mw31ck3rt/h_da_SmartCane_2023/README.md

# h_da_SmartCane_2023

created by Thomas Eistetter and Marian Weickert as their Masterthesis at Hochschule Darmstadt (h_da)
processing period: 16.01.2023 to 30.10.2023
