mw31ck3rt/h_da_SmartCane_2023/V.1/Hardware/Anschluss_Sensoraufnahme_V1.pdf

Anschluss Sensoraufnahme V1

Elektrischer Anschluss

PS/2 Stecker | PS/2 Buchse | Raspberry Pi Zero W
Aderfarbe | Aderfarbe | GPIO
Rot | Schwarz | GND
Grün | Rot | 5V
Gelb | Gelb | SDA (2)
Orange | Grün | SCL (3)
Schwarz | Braun | Rx (15)
Braun | Weiß | Reserve

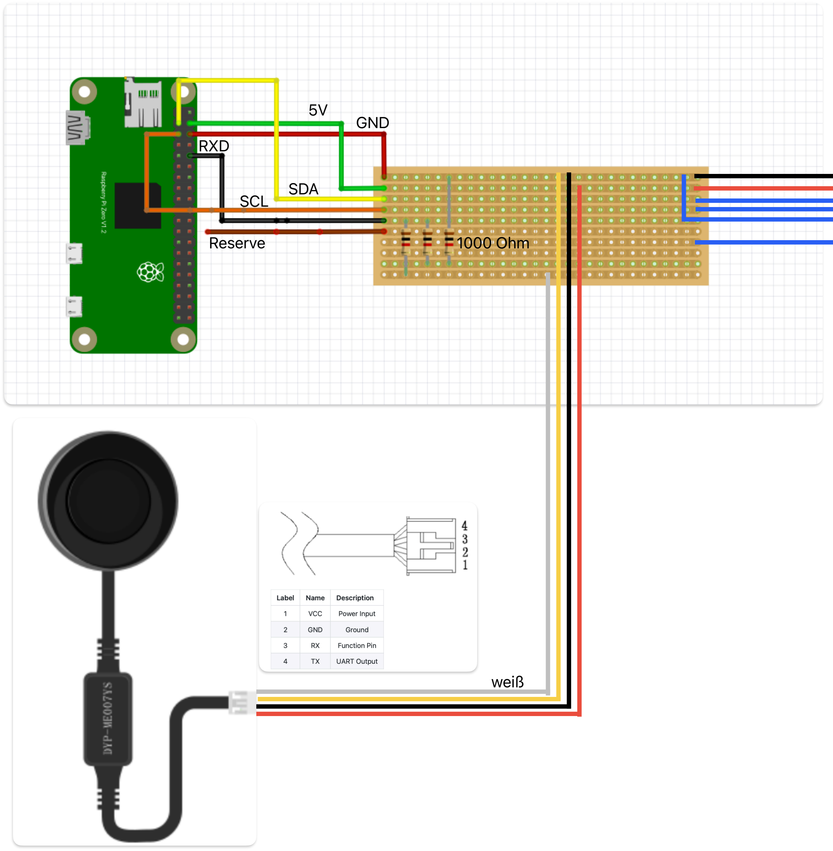
[picture p1: figure]
GND 5V; SDA SCL; RXD; weiß; Reserve; 1000 Ohm

Hinweis: AuNauanleitung für Gehäuse siehe V2

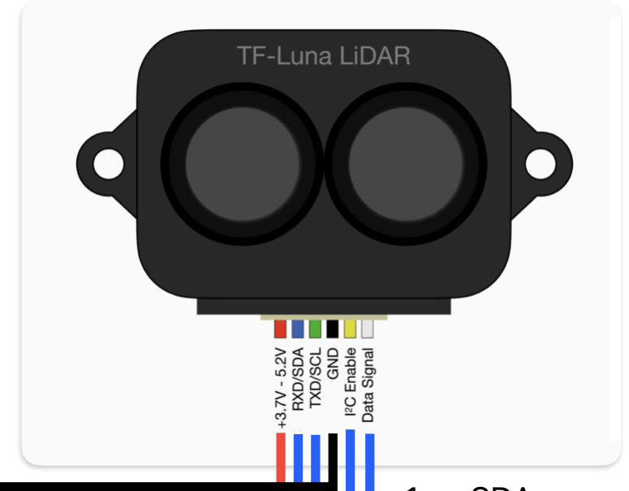
[picture p2: figure]

1 -> SDA
2 -> SCL
3 -> I2C
4 -> Data
