mw31ck3rt/h_da_SmartCane_2023/V.2/Hardware/v2_stueckliste.pdf

### Stückliste V.2

Pos. | Artikel | Typ | Bestellnummer | Menge | ME | Preis / ME | Preis gesamt | Bezugsquelle | Kategorie
1 Blechschraube ISO 1481 | 2,2x6,5 | TOOLCRAFT 228745 Senkschraube (https://www.conrad.de/de/p/toolcraft-228745-senkschrauben-6-5-mm-schlitz-din-7971-c-iso-1481-stahl-verzinkt-20-st-228745.html) | 228745 | 1 | Pack | 1,49 € | 1,49 € | Conrad Elektronik | BLS-Grif
2 Blechschraube ISO 1481 | 2,2x9,5 | TOOLCRAFT 228737 Senkschraube (https://www.conrad.de/de/p/toolcraft-228737-senkschrauben-9-5-mm-schlitz-din-7971-c-iso-1481-stahl-verzinkt-20-st-228737.html) | 228737 | 1 | Pack | 1,99 € | 1,99 € | Conrad Elektronik | BLS-Grif
3 | Blindenlangstock | VISIONU 140cm Blindenlangstock (https://www.amazon.de/gp/product/B019LOFY0Q/ref=ppx_yo_dt_b_asin_title_o08_s00?ie=UTF8&th=1&psc=1) | B019LOFY0Q | 1 | Stk | 27,00 € | 27,00 € | Amazon | BLS-Grif
4 | BLS-Griff inkl. Deckel | 3D-Druck | — | 2 | Stk | 3,00 € | 6,00 € | h_da | BLS-Grif
5 | PS/2 Buchse | BKL Electronic 0204027 (https://www.conrad.de/de/p/bkl-electronic-0204027-miniatur-din-rundsteckverbinder-buchse-einbau-vertikal-polzahl-num-6-schwarz-1-st-734209.html) | 734209 | 2 | Stk | 4,29 € | 8,58 € | Conrad Elektronik | BLS-Grif
6 | Aktuatoren | Grewus EXS241408WB | EXS241408WB | 2 | Stk | | 0,00 € | Grewus GmbH | Bodypack
7 | Aktuatoren | Grewus EXS2608L-03A | EXS2608L-03A | 2 | Stk | | 0,00 € | Grewus GmbH | Bodypack
8 | Drehknopf | Cliff CL170842CR CL170842BR (https://www.conrad.de/de/p/cliff-cl170853br-cl170853br-drehknopf-schwarz-rot-o-x-h-16-8-mm-x-14-5-mm-1-st-704838.html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) | 704838 | 1 | Stk | 0,75 € | 0,75 € | Conrad Elektronik | Bodypack
9 | Drehschalter | TRU COMPONENTS TC-DS4X3L (https://www.conrad.de/de/p/tru-components-tc-ds4x3l-tc-ds4x3l-drehschalter-0-35-a-schaltpositionen-3-3-x-30-1-st-1589500.html) | 1589500 | 1 | Stk | 5,49 € | 5,49 € | Conrad Elektronik | Bodypack
10 | Drucktaster | TRU COMPONENTS TC-10091012 GQ12B-10/J/N/A (https://www.conrad.de/de/p/tru-components-tc-10091012-gq12b-10-j-n-a-drucktaster-48-v-dc-2-a-1-x-aus-ein-tastend-ip65-1-st-2522753.html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) | 2522753 | 2 | Stk | 4,49 € | 8,98 € | Conrad Elektronik | Bodypack
11 | Einplatinencomputer | Raspberry Pi Zero W (https://botland.de/raspberry-pi-zero-module-und-kits/16722-raspberry-pi-zero-wh-basis-kit-5904422344948.html) | RPI-16722 | 1 | Stk | 37,90 € | 37,90 € | Botland | Bodypack
12 Gewinde-Schraube | M2x10 | TOOLCRAFT 815560 Zylinderschrauben M2 10 mm (https://www.conrad.de/de/p/toolcraft-815560-zylinderschrauben-m2-10-mm-schlitz-din-84-stahl-verzinkt-100-st-815560.html) | 815560 | 1 | Pack | 3,49 € | 3,49 € | Conrad Elektronik | Bodypack
13 Gewinde-Schraube | M2x25 | TOOLCRAFT 888677 Zylinderschrauben M2 25 mm (https://www.conrad.de/de/p/toolcraft-888677-zylinderschrauben-m2-25-mm-schlitz-din-84-stahl-verzinkt-1-st-888677.html) | 888677 | 2 | Stk | 0,18 € | 0,36 € | Conrad Elektronik | Bodypack
14 | Gürtelclip | micoshop 5 x 54 x 25 mm Gürtel-Holster-Clip-Verschluss (https://www.amazon.de/gp/product/B07KLJK62B/ref=ppx_yo_dt_b_asin_title_o06_s00?ie=UTF8&psc=1) | B07KY7BCGS | 1 | Pack | 3,99 € | 3,99 € | Amazon | Bodypack
15 | I2C-Multiplexer | Adafruit TCA9548A (https://botland.de/multiplexer/4915-tca9548a-modul-mit-i2c-multiplexer-adafruit-2717-5904422354268.html) | ADA-04915 | 1 | Stk | 9,50 € | 9,50 € | Botland | Bodypack
16 | Kabel BP - BLS | BKL Elektronik 0204097 (https://www.conrad.de/de/p/bkl-electronic-0204097-miniatur-din-rundsteckverbinder-stecker-gerade-polzahl-num-6-violett-1-st-601847.html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) | 601847 | 1 | Stk | 6,99 € | 6,99 € | Conrad Elektronik | Bodypack
17 | Kabel BP - HTS | Lapp Unitronic FD CY 4x0,25mm^2 27427-1 (https://www.conrad.de/de/p/lapp-27427-1-datenleitung-unitronic-fd-cy-4-x-0-25-mm-grau-meterware-609214.html) | 609214 | 1 | m | 5,49 € | 5,49 € | Conrad Elektronik | Bodypack
18 | Kabel Stemma QT | SparkFun PRT-17258 (https://botland.de/qwiic-verbindungskabel/19837-flexibles-qwiic-kabel-mit-4-poligem-stecker-20-cm-sparkfun-prt-17258-5904422352394.html) | SPF-19837 | 2 | Stk | 2,50 € | 5,00 € | Botland | Bodypack
19 | Kabelverschraubung PG7 | TRU COMPONENTS 1593007 (https://www.conrad.de/de/p/tru-components-1593007-kabelverschraubung-pg7-polyamid-silber-grau-ral-7001-1-st-1593007.html) | 1593007 | 3 | Stk | 0,87 € | 2,61 € | Conrad Elektronik | Bodypack
20 | Kippschalter | TRU COMPONENTS TC-9218548 (https://www.conrad.de/de/p/tru-components-tc-9218548-kippschalter-250-v-ac-2-a-2-x-ein-ein-rastend-1-st-2304637.html) | 2304637 | 2 | Stk | 1,29 € | 2,58 € | Conrad Elektronik | Bodypack
21 | Klettband | TOOLCRAFT KL50X1000C (https://www.conrad.de/de/p/toolcraft-kl50x1000c-klettband-zum-aufkleben-haft-und-flauschteil-extrastark-l-x-b-1000-mm-x-50-mm-schwarz-1-m-419956.html) | 419956 | 1 | Pack | 4,49 € | 4,49 € | Conrad Elektronik | Bodypack
22 | Litze 0,25mm^2 | LIY 0,25mm^2 schwarz (https://www.conrad.de/de/p/lapp-4126001s-litze-liy-1-x-0-25-mm-schwarz-meterware-607941.html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) | 607941 | 3 | m | 0,40 € | 1,20 € | Conrad Elektronik | Bodypack
23 | Lochrasterplatte | Rademacher WR-Typ 715-5 (https://www.conrad.de/de/p/rademacher-wr-typ-715-5-platine-hartpapier-l-x-b-160-mm-x-100-mm-35-m-rastermass-2-50-mm-inhalt-1-st-521140.html) | 521140 | 1 | Stk | 3,79 € | 3,79 € | Conrad Elektronik | Bodypack
24 | LRA-Treiberboard | Adafruit DRV2605L (https://botland.de/vibrationsmotoren/21825-drv2605l-haptischer-motortreiber-adafruit-2305.html) | ADA-21825 | 2 | Stk | 10,50 € | 21,00 € | Botland | Bodypack
25 | Mutter M2 | TOOLCRAFT 815608 Sechskantmuttern M2 DIN 934 Stahl verzinkt 100 St. (https://www.conrad.de/de/p/toolcraft-815608-sechskantmuttern-m2-din-934-stahl-verzinkt-100-st-815608.html) | 815608 | 1 | Pack | 1,99 € | 1,99 € | Conrad Elektronik | Bodypack
26 | Powerbank | Intenso Powerbank XS 5000 (https://www.amazon.de/dp/B07Z6N28RD?psc=1&ref=ppx_yo2ov_dt_b_product_details) | B07Z6N28RD | 1 | Stk | 12,99 € | 12,99 € | Conrad Elektronik | Bodypack
27 | Universalgehäuse | TRU COMPONENTS KST 215 03215000.H (https://www.conrad.de/de/p/tru-components-kst-215-03215000-h-industrie-gehaeuse-120-x-80-x-55-abs-schiefer-grau-1-st-1483249.html) | 1483249 | 1 | Stk | 10,99 € | 10,99 € | Conrad Elektronik | Bodypack
28 | Universalgehäuse | Hammond Electronics 1551PFLBK (https://www.conrad.de/de/p/hammond-electronics-1551pflbk-euro-gehaeuse-40-x-40-x-20-abs-schwarz-1-st-534304.html) | 534304 | 1 | Stk | 3,49 € | 3,49 € | Conrad Elektronik | Bodypack
29 | USB-Kabel | Digitus USB-Kabel USB 2.0 USB-A Stecker, USB-Micro-B Stecker 1.00 m (https://www.conrad.de/de/p/digitus-usb-kabel-usb-2-0-usb-a-stecker-usb-micro-b-stecker-1-00-m-schwarz-rund-doppelt-geschirmt-db-300127-010-s-1556351.html) | 1556351 | 1 | Stk | 5,99 € | 5,99 € | Conrad Elektronik | Bodypack
Gesamt | | | | | | | 204,12 €

1
