mw31ck3rt/h_da_SmartCane_2023/V.1/Hardware/v1_stueckliste.pdf

### Stückliste V.0 / V.1

Pos. Pos. | Artikel | Typ | Bestellnummer | Menge | ME | Preis / ME | Preis gesamt | Bezugsquelle | Kategorie
1 | Abzweigkasten | Hensel KF 0200 H (http://www.apple.com/de/) | 2295844 | 1 | Stk | 8,99 € | 8,99 € | Conrad Elektronik | Bodypack
2 | Drucktaster | TRU COMPONENTS TC-10091012 GQ12B-10/J/N/A (https://www.conrad.de/de/p/tru-components-tc-10091012-gq12b-10-j-n-a-drucktaster-48-v-dc-2-a-1-x-aus-ein-tastend-ip65-1-st-2522753.html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) | 2522753 | 2 | Stk | 4,49 € | 8,98 € | Conrad Elektronik | Bodypack
3 | Schalter I/O | Wippschalter KCD1-12*18,8mm | R7-B-7-3 | 1 | Stk | 1,10 € | 1,10 € | Funduino | Bodypack
4 | USB-Kabel | deleyCON 0,15m Nylon USB-C Kabel (https://www.amazon.de/dp/B08HSBKTC9?ref=ppx_yo2ov_dt_b_product_details&th=1) | MK3889 | 1 | Stk | 4,39 € | 4,39 € | Amazon | Bodypack
5 | Flachsteckhülsen | Vogt 3902 (https://www.conrad.de/de/p/vogt-verbindungstechnik-3902-flachsteckhuelse-steckbreite-4-8-mm-steckdicke-0-8-mm-180-teilisoliert-rot-1-st-736933.html) | 736933 | 2 | Stk | 0,32 € | 0,64 € | Conrad Elektronik | Bodypack
6 | Lochrasterplatte | Rademacher WR-Typ 811-5 (https://www.conrad.de/de/p/rademacher-wr-typ-811-5-platine-hartpapier-l-x-b-160-mm-x-100-mm-35-m-rastermass-2-54-mm-inhalt-1-st-529593.html) | 529593 | 1 | Stk | 4,29 € | 4,29 € | Conrad Elektronik | Bodypack
7 | Kabelverschraubung PG7 | TRU COMPONENTS 1593007 (https://www.conrad.de/de/p/tru-components-1593007-kabelverschraubung-pg7-polyamid-silber-grau-ral-7001-1-st-1593007.html) | 1593007 | 2 | Stk | 0,87 € | 1,74 € | Conrad Elektronik | Bodypack
8 | Einplatinencomputer | Raspberry Pi Zero W (https://botland.de/raspberry-pi-zero-module-und-kits/16722-raspberry-pi-zero-wh-basis-kit-5904422344948.html) | RPI-16722 | 1 | Stk | 37,90 € | 37,90 € | Botland | Bodypack
9 | Battery HAT | Waveshare 15141 (https://botland.de/raspberry-pi-hat-machtschilde/13459-li-ion-battery-hat-raspberry-pi-shield-waveshare-15141-5904422377298.html) | WSR-13459 | 1 | Stk | 19,90 € | 19,90 € | Botland | Bodypack
| Akkumulator Li-Ion 14500 | Xtar 14500 Li-Ion 800mAh (https://botland.de/li-ionen-akkus/7202-zelle-14500-li-ion-xtar-800mah-mit-sicherheit-6952918341338.html) | AKU-07202 | 1 | Stk | 5,50 € | 5,50 € | Botland | Bodypack
10 Gewinde-Schraube | M2x30 | TOOLCRAFT 888678 Zylinderschrauben M2 30 mm (https://www.conrad.de/de/p/toolcraft-888678-zylinderschrauben-m2-30-mm-schlitz-din-84-stahl-verzinkt-1-st-888678.html) | 888678 | 2 | Stk | 0,20 € | 0,40 € | Conrad Elektronik | Bodypack
11 Gewinde-Schraube | M2x10 | TOOLCRAFT 815560 Zylinderschrauben M2 10 mm (https://www.conrad.de/de/p/toolcraft-815560-zylinderschrauben-m2-10-mm-schlitz-din-84-stahl-verzinkt-100-st-815560.html) | 815560 | 1 | Pack | 3,49 € | 3,49 € | Conrad Elektronik | Bodypack
12 | Mutter M2 | TOOLCRAFT 815608 Sechskantmuttern M2 DIN 934 Stahl verzinkt 100 St. (https://www.conrad.de/de/p/toolcraft-815608-sechskantmuttern-m2-din-934-stahl-verzinkt-100-st-815608.html) | 815608 | 1 | Pack | 1,99 € | 1,99 € | Conrad Elektronik | Bodypack
13 | Mutter M3 | TOOLCRAFT 888718 Sechskantmuttern M3 DIN 934 (https://www.conrad.de/de/p/toolcraft-888718-sechskantmuttern-m3-din-934-stahl-verzinkt-1-st-888718.html) | 888718 | 2 | Stk | 0,05 € | 0,10 € | Conrad Elektronik | Bodypack
14 | Gürtelclip | micoshop 5 x 54 x 25 mm Gürtel-Holster-Clip-Verschluss (https://www.amazon.de/gp/product/B07KLJK62B/ref=ppx_yo_dt_b_asin_title_o06_s00?ie=UTF8&psc=1) | B07KY7BCGS | 1 | Pack | 3,99 € | 3,99 € | Amazon | Bodypack
15 Linsenblechschraube | 2,9x9,5 | TOOLCRAFT 888701 Linsenblechschrauben 2.9 mm 9.5 mm (https://www.conrad.de/de/p/toolcraft-888701-linsenblechschrauben-2-9-mm-9-5-mm-kreuzschlitz-phillips-din-7981-stahl-verzinkt-1-st-888701.html) | 888701 | 2 | Stk | 0,05 € | 0,10 € | Conrad Elektronik | Bodypack
16 | Litze 0,25mm^2 | LIY 0,25mm^2 schwarz (https://www.conrad.de/de/p/lapp-4126001s-litze-liy-1-x-0-25-mm-schwarz-meterware-607941.html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) | 607941 | 3 | m | 0,40 € | 1,20 € | Conrad Elektronik | Bodypack
17 | Kabel BP - HS | Lapp Unitronic FD CY 4x0,25mm^2 27427-1 (https://www.conrad.de/de/p/lapp-27427-1-datenleitung-unitronic-fd-cy-4-x-0-25-mm-grau-meterware-609214.html) | 609214 | 2 | m | 5,49 € | 10,98 € | Conrad Elektronik | Bodypack
18 | Kabel BP - BLS | BKL Elektronik 0204097 (https://www.conrad.de/de/p/bkl-electronic-0204097-miniatur-din-rundsteckverbinder-stecker-gerade-polzahl-num-6-violett-1-st-601847.html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) | 601847 | 1 | Stk | 6,99 € | 6,99 € | Conrad Elektronik | Bodypack
19 | Handschuhe | PROANTI Unterziehhandschuhe V01 (https://www.amazon.de/PROANTI-Unterziehhandschuhe-Innenhandschuhe-Unterzieh-Handschuhe/dp/B00FWWF0NI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) | 127-M/L-V01 | 1 | Paar | 9,99 € | 9,99 € | Amazon | Handschuh
20 | Universalgehäuse | TRU COMPONENTS KST 205 03205000.H (https://www.conrad.de/de/p/tru-components-kst-205-03205000-h-universal-gehaeuse-52-x-50-x-35-abs-schiefer-grau-1-st-1483244.html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) | 1483244 | 1 | Stk | 4,99 € | 4,99 € | Conrad Elektronik | Handschuh
21 | Kabelverschraubung PG7 | TRU COMPONENTS 1593007 (https://www.conrad.de/de/p/tru-components-1593007-kabelverschraubung-pg7-polyamid-silber-grau-ral-7001-1-st-1593007.html) | 1593007 | 1 | Stk | 0,87 € | 0,87 € | Conrad Elektronik | Handschuh
22 | Aktuatoren | Grewus LRA 08235W A | LRA 08235W A | 3 | Stk | | 0,00 € | Grewus GmbH | Handschuh
23 Gewinde-Schraube | M2x25 | TOOLCRAFT 888677 Zylinderschrauben M2 25 mm (https://www.conrad.de/de/p/toolcraft-888677-zylinderschrauben-m2-25-mm-schlitz-din-84-stahl-verzinkt-1-st-888677.html) | 888677 | 2 | Stk | 0,18 € | 0,36 € | Conrad Elektronik | Handschuh
25 | Kontaktkleber | Kömmerling Kövulfix Rekord (https://www.amazon.de/K%C3%B6mmerling-Schuhkleber-Absatzkleber-Kontaktkleber-Schuhmacherkleber/dp/B017BK6MDK) | B017BK6MDK | 1 | Stk | 7,48 € | 7,48 € | Amazon | Handschuh
26 | Epoxidharz-Kleber | TOOLCRAFT TC-EPO60-24 (https://www.conrad.de/de/p/toolcraft-tc-epo60-24-zwei-komponentenkleber-tc-epo60-24-25-ml-886520.html) | 886520 | 1 | Stk | 7,99 € | 7,99 € | Conrad Elektronik | Handschuh
27 | Schrumpfschlauch | | | 3 | | | 0,00 € | | Handschuh

1

Pos. | Artikel | Typ | Bestellnummer | Menge | ME | Preis / ME | Preis gesamt | Bezugsquelle | Kategorie
28 | Klettband 10mm | deleyCON 10m Klett (https://www.amazon.de/dp/B077B9MKP4?ref=ppx_yo2ov_dt_b_product_details&th=1) | B077B9MKP4 | 1 | Stk | 7,99 € | 7,99 € | Amazon | Handschuh
29 | Kabel Qwiic | SparkFun PRT-17258 (https://botland.de/qwiic-verbindungskabel/19837-flexibles-qwiic-kabel-mit-4-poligem-stecker-20-cm-sparkfun-prt-17258-5904422352394.html) | SPF-19837 | 2 | Stk | 2,50 € | 5,00 € | Botland | Handschuh
30 | LRA-Treiberboard | Adafruit DRV2605L (https://botland.de/vibrationsmotoren/21825-drv2605l-haptischer-motortreiber-adafruit-2305.html) | ADA-21825 | 3 | Stk | 10,50 € | 31,50 € | Botland | Handschuh
31 | I2C-Multiplexer | Adafruit TCA9548A (https://botland.de/multiplexer/4915-tca9548a-modul-mit-i2c-multiplexer-adafruit-2717-5904422354268.html) | ADA-04915 | 1 | Stk | 9,50 € | 9,50 € | Botland | Handschuh
32 | PS/2 Buchse | BKL Electronic 0204027 (https://www.conrad.de/de/p/bkl-electronic-0204027-miniatur-din-rundsteckverbinder-buchse-einbau-vertikal-polzahl-num-6-schwarz-1-st-734209.html) | 734209 | 1 | Stk | 4,29 € | 4,29 € | Conrad Elektronik | BLS-Griff
33 | BLS-Griff inkl. Deckel | 3D-Druck | — | 1 | Stk | 2,50 € | 2,50 € | h_da | BLS-Griff
34 Blechschraube ISO 1481 | 2,2x6,5 | TOOLCRAFT 228745 Senkschraube (https://www.conrad.de/de/p/toolcraft-228745-senkschrauben-6-5-mm-schlitz-din-7971-c-iso-1481-stahl-verzinkt-20-st-228745.html) | 228745 | 1 | Pack | 1,49 € | 1,49 € | Conrad Elektronik | BLS-Griff
35 Blechschraube ISO 1481 | 2,2x9,5 | TOOLCRAFT 228737 Senkschraube (https://www.conrad.de/de/p/toolcraft-228737-senkschrauben-9-5-mm-schlitz-din-7971-c-iso-1481-stahl-verzinkt-20-st-228737.html) | 228737 | 1 | Pack | 1,99 € | 1,99 € | Conrad Elektronik | BLS-Griff
36 | Blindenlangstock | VISIONU 140cm Blindenlangstock (https://www.amazon.de/gp/product/B019LOFY0Q/ref=ppx_yo_dt_b_asin_title_o08_s00?ie=UTF8&th=1&psc=1) | B019LOFY0Q | 1 | S# | 27,00 € | 27,00 € | Amazon | BLS-Griff
Gesamt | | | | | | | 245,61 €

2
