mw31ck3rt/h_da_SmartCane_2023/V.2/Hardware/3D-Dateien/BLS_Griff_Standard_Grundkoerper.stl

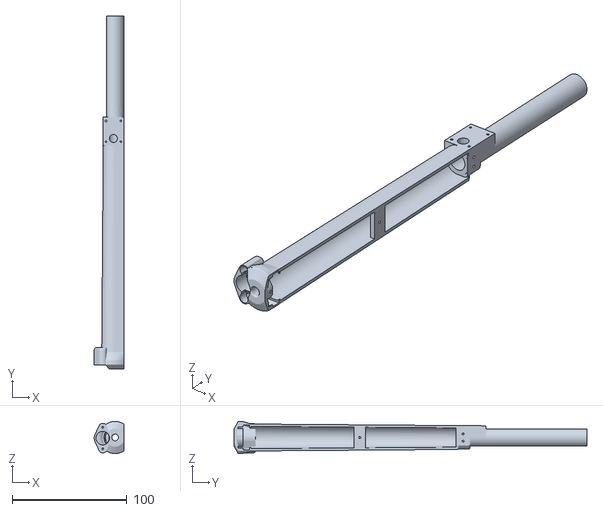
[picture p3: CAD file, 2023-10-12]
V.2/Hardware/3D-Dateien/BLS_Griff_Standard_Grundkoerper.stl
25.8 x 307.7 x 28.0
