mw31ck3rt/h_da_SmartCane_2023/V.2/Hardware/3D-Dateien/Sensoraufnahme_stl/Deckel TF Luna.stl

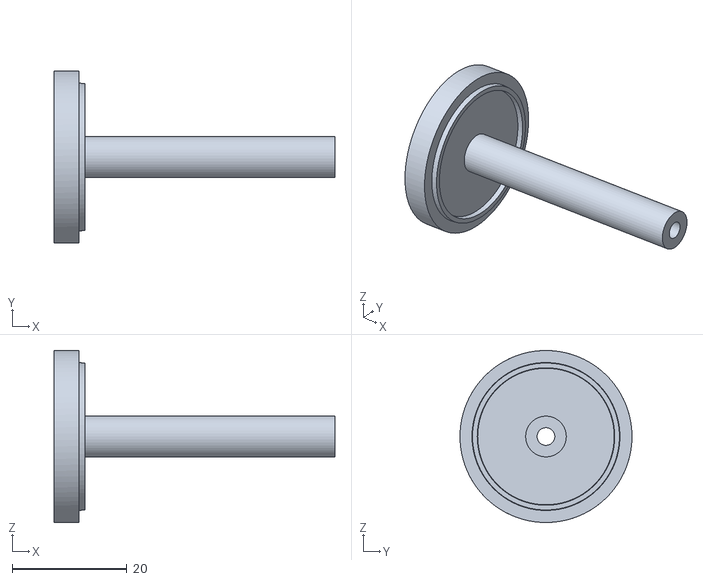
[picture p4: CAD file, 2023-10-15]
V.2/Hardware/3D-Dateien/Sensoraufnahme_stl/Deckel TF Luna.stl
49.0 x 30.0 x 30.0
