mw31ck3rt/h_da_SmartCane_2023/V.2/Hardware/3D-Dateien/BLS_Griff_ausV1_Deckel.stl

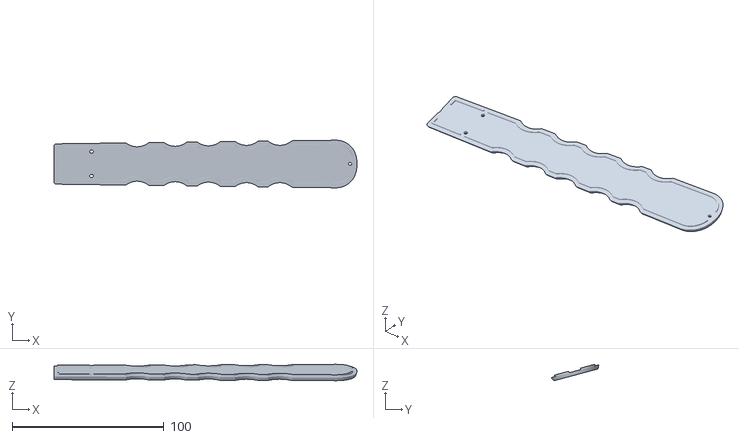
[picture p5: CAD file, 2023-10-12]
V.2/Hardware/3D-Dateien/BLS_Griff_ausV1_Deckel.stl
199.7 x 31.4 x 10.9
