mw31ck3rt/h_da_SmartCane_2023/V.2/Hardware/3D-Dateien/Sensoraufnahme_stl/Deckel URM09.stl

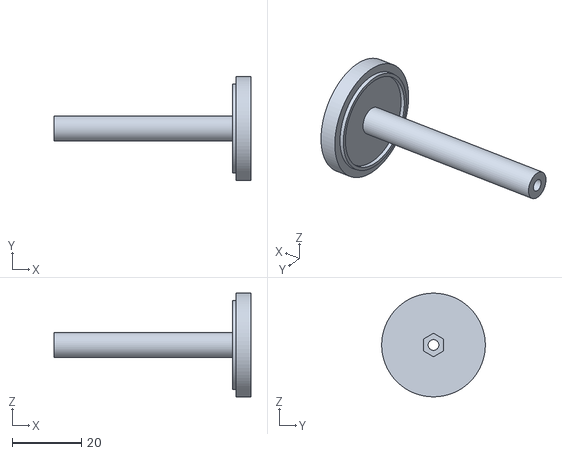
[picture p6: CAD file, 2023-10-15]
V.2/Hardware/3D-Dateien/Sensoraufnahme_stl/Deckel URM09.stl
57.0 x 30.0 x 30.0
