mw31ck3rt/h_da_SmartCane_2023/V.2/Hardware/3D-Dateien/BLS_Griff_ausV1_Grundkoerper.stl

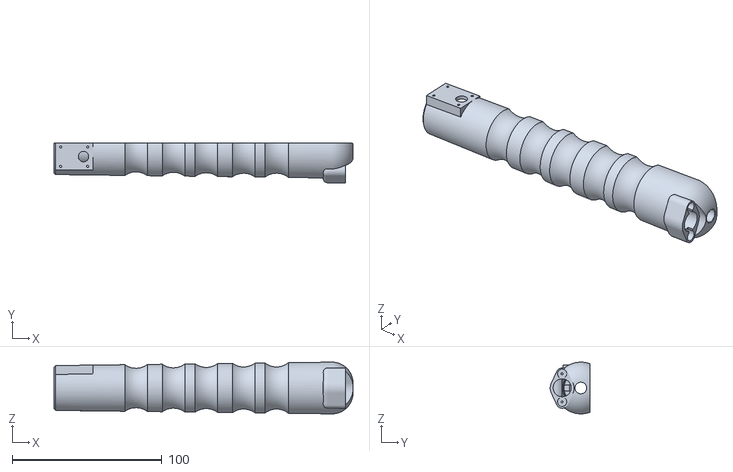
[picture p7: CAD file, 2023-10-12]
V.2/Hardware/3D-Dateien/BLS_Griff_ausV1_Grundkoerper.stl
200.0 x 26.5 x 34.6
