mw31ck3rt/h_da_SmartCane_2023/V.2/Hardware/3D-Dateien/Sensoraufnahme_stl/Mittelkörper.stl

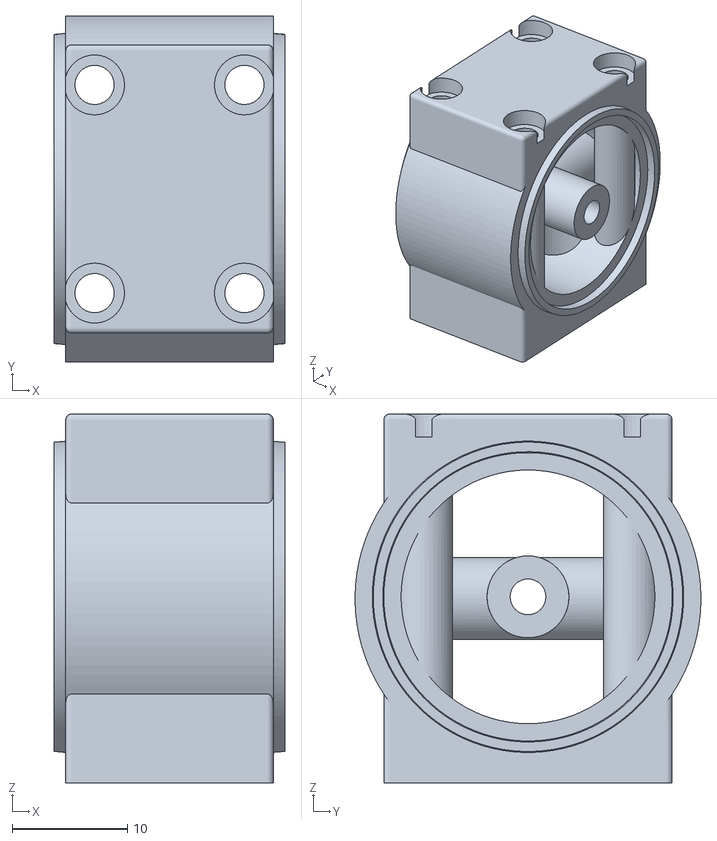
[picture p8: CAD file, 2023-10-15]
V.2/Hardware/3D-Dateien/Sensoraufnahme_stl/Mittelkörper.stl
20.0 x 30.0 x 32.0
