mw31ck3rt/h_da_SmartCane_2023/V.2/Hardware/3D-Dateien/BLS_Griff_Standard_Deckel.stl

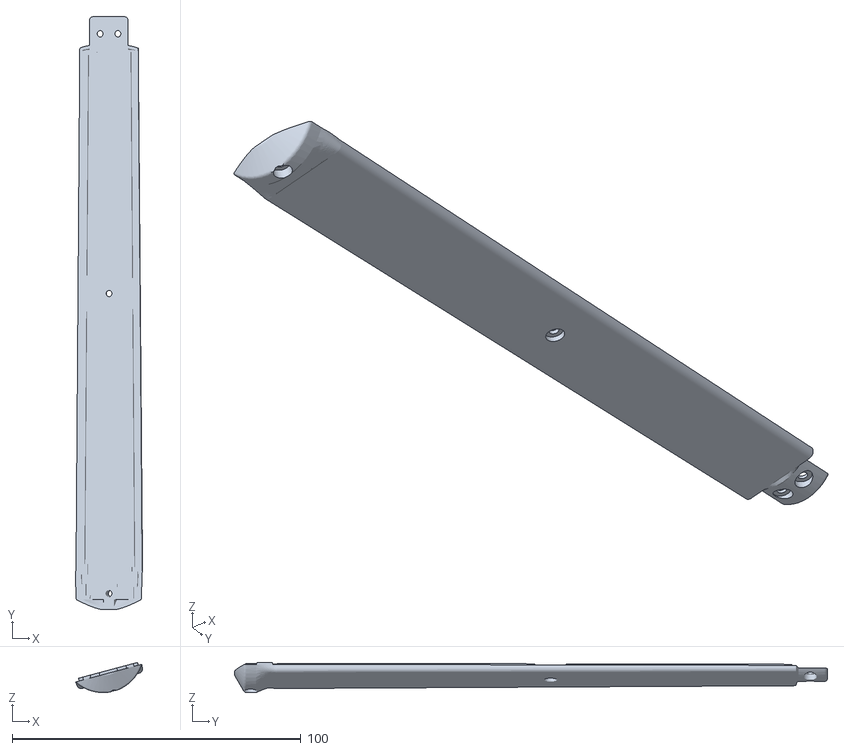
[picture p9: CAD file, 2023-10-12]
V.2/Hardware/3D-Dateien/BLS_Griff_Standard_Deckel.stl
23.3 x 205.5 x 10.5
