mw31ck3rt/h_da_SmartCane_2023/V.2/Hardware/3D-Dateien/Sensoraufnahme_stl/Gehäuse URM09.stl

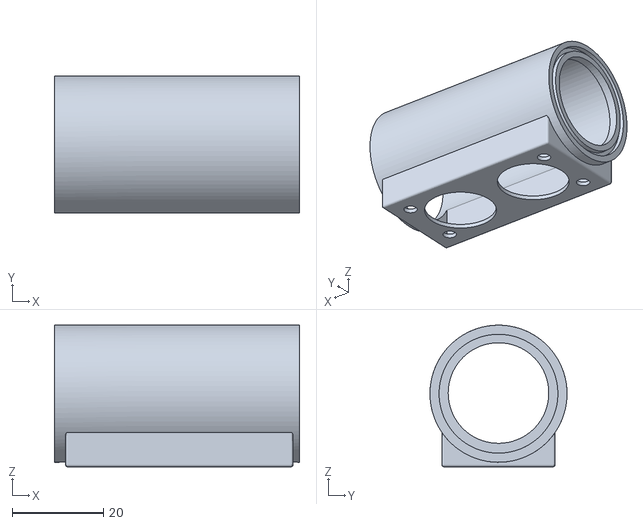
[picture p10: CAD file, 2023-10-15]
V.2/Hardware/3D-Dateien/Sensoraufnahme_stl/Gehäuse URM09.stl
53.6 x 30.0 x 31.0
