mw31ck3rt/h_da_SmartCane_2023/V.2/Hardware/3D-Dateien/Sensoraufnahme_stl/Gehäuse TF Luna.stl

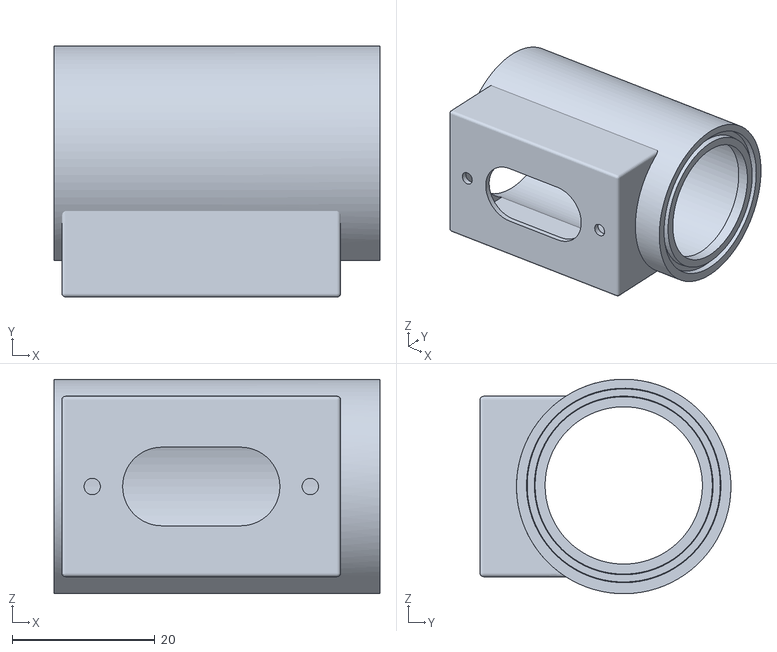
[picture p11: CAD file, 2023-10-15]
V.2/Hardware/3D-Dateien/Sensoraufnahme_stl/Gehäuse TF Luna.stl
45.6 x 35.1 x 30.0
