mw31ck3rt/h_da_SmartCane_2023/V.1/Hardware/3D-Dateien/Sensoraufnahme_stl/Körper1.stl

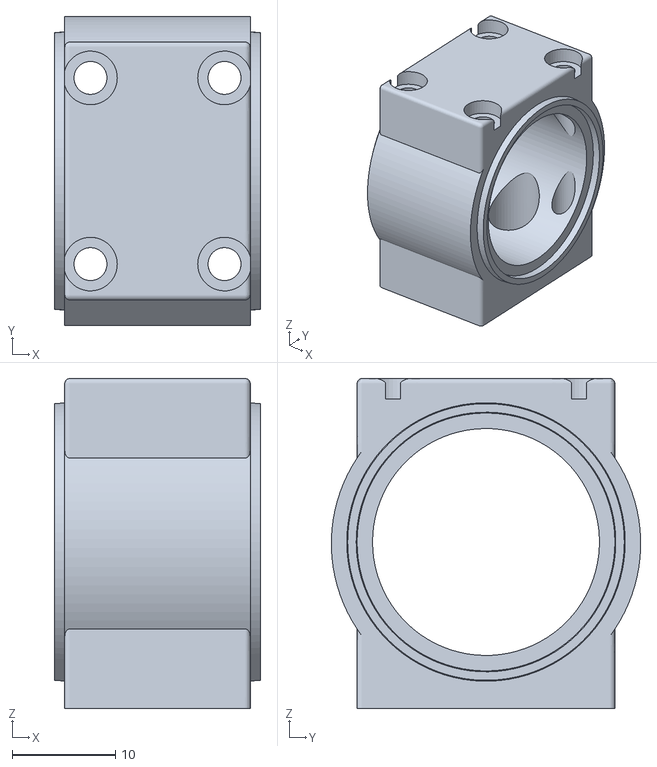
[picture p12: CAD file, 2023-10-15, an earlier design]
V.1/Hardware/3D-Dateien/Sensoraufnahme_stl/Körper1.stl
20.0 x 30.0 x 32.0
