mw31ck3rt/h_da_SmartCane_2023/V.1/Hardware/3D-Dateien/v1_bls_griff_deckel.stl

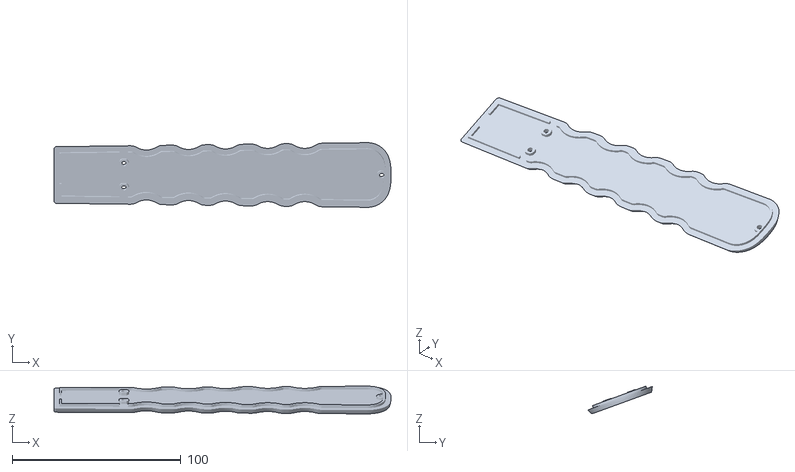
[picture p13: CAD file, 2023-10-08, an earlier design]
V.1/Hardware/3D-Dateien/v1_bls_griff_deckel.stl
200.0 x 38.4 x 16.4
