mw31ck3rt/h_da_SmartCane_2023/V.1/Hardware/3D-Dateien/v1_bls_griff_grundkoerper.stl

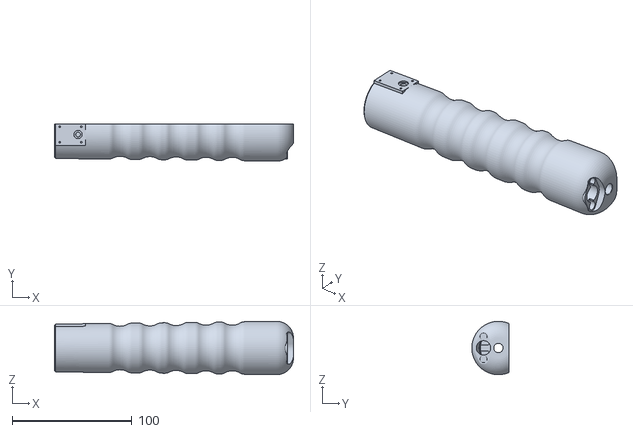
[picture p15: CAD file, 2023-10-08, an earlier design]
V.1/Hardware/3D-Dateien/v1_bls_griff_grundkoerper.stl
200.0 x 31.3 x 44.6
