mw31ck3rt/h_da_SmartCane_2023/V.1/Hardware/3D-Dateien/Sensoraufnahme_stl/Körper3.stl

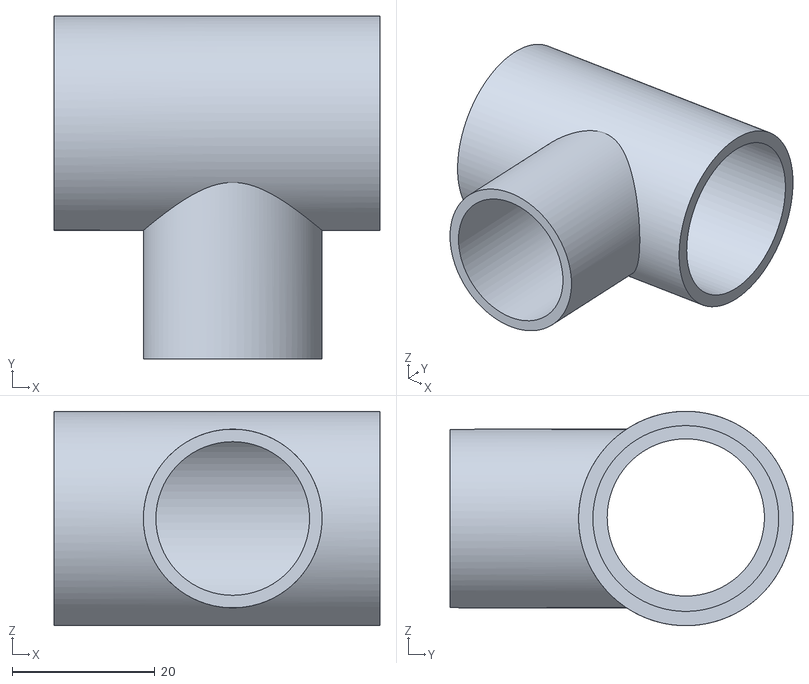
[picture p16: CAD file, 2023-10-15, an earlier design]
V.1/Hardware/3D-Dateien/Sensoraufnahme_stl/Körper3.stl
45.6 x 48.0 x 30.0
