mw31ck3rt/h_da_SmartCane_2023/(list of files, cad)

Other CAD files:
V.1/Hardware/3D-Dateien/Sensoraufnahme_stl/Körper2.stl
V.1/Hardware/3D-Dateien/Sensoraufnahme_SmartCane_Masterthesis v12.f3d
V.1/Hardware/3D-Dateien/v1_bls_griff.f3z
V.2/Hardware/3D-Dateien/BLS_Griff_Standard.f3z
V.2/Hardware/3D-Dateien/BLS_Griff_ausV1.f3z
V.2/Hardware/3D-Dateien/Sensoraufnahme_SmartCane_V2_Masterthesis v5.f3d
