mw31ck3rt/h_da_SmartCane_2023/V.1/Firmware/setup_smart_cane.pdf

Setup Raspberry Pi für Smart Cane V1 und V2

Was wird benötigt?
Raspberry Pi Zero W, Laptop, WLAN, Netzteil für Raspberry Pi, microSDHC-Karte, evtl. Adapter für microSD-Karte
1. Installation Raspberry Pi OS
a. Download und Installation Raspberry Pi Imager (https://www.raspberrypi.com/software/)
b. Installiere Raspberry Pi OS (32-BIT) mit Raspberry Pi Imager
Vorher: Unter Einstellungen SSH aktivieren und Hostname, Benutzer und Password vergeben

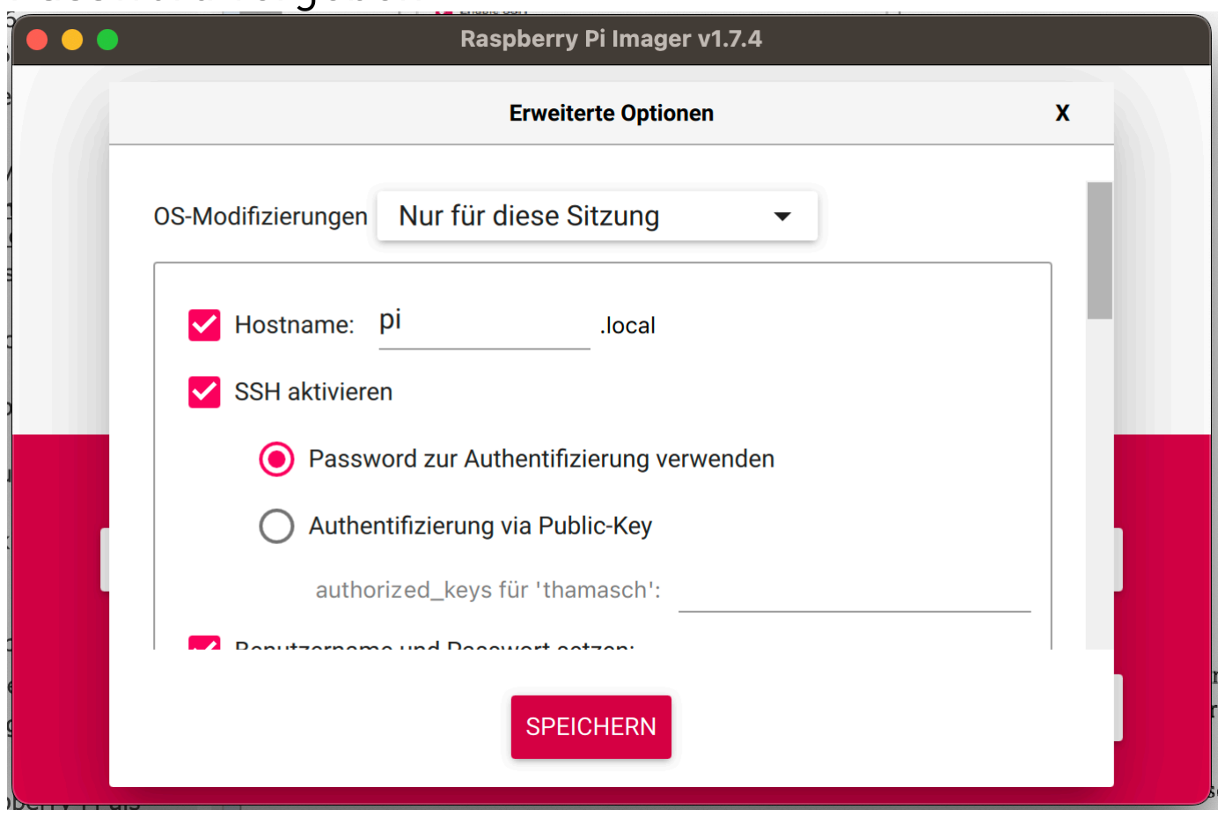
[picture p17: figure]

2. Mit Rasberry Pi über SSH verbinden und VNC aktivieren
a. Unter Terminal mit „ssh [Benutzer]@[Host]“ mit Raspberry Pi verbinden. Mit den Befehlen „sudo apt-get update“ und „sudo apt-get upgrade“ kann der Pi bei Bedarf aktualisiert werden.

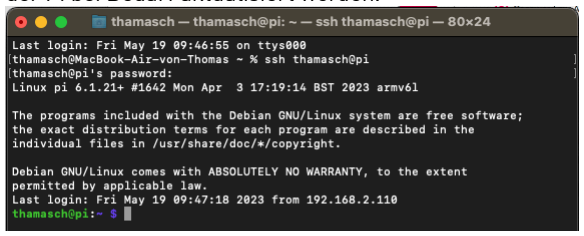
[picture p18: figure]

Setup Smart Cane V1 und V2

b. Mit dem Befehl „sudo raspi-config“ kann VNC aktiviert werden.
Unter 3 Interface Options befindet sich der Menüpunkt für die Aktivierung von VNC.

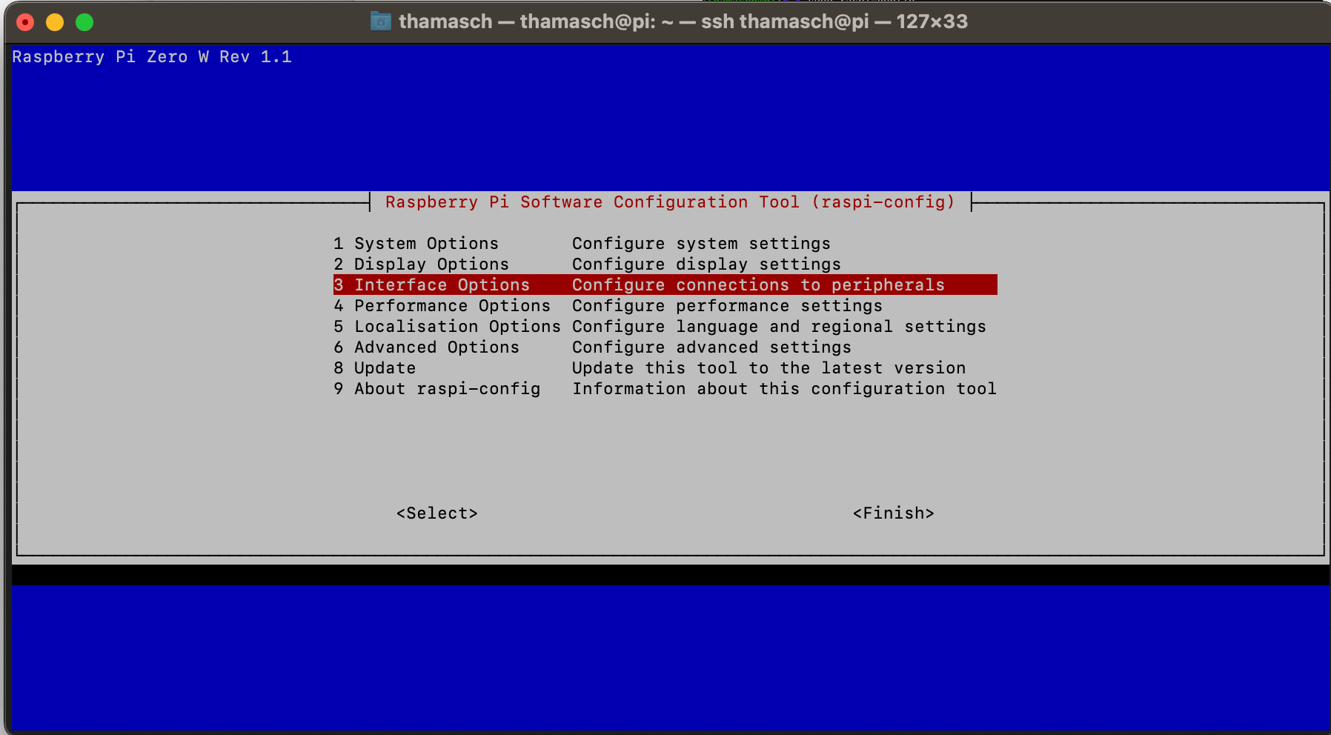
[picture p19: figure]

3. VNC installieren und mit Raspberry Pi verbinden.
a. VNC Viewer unter
https://www.realvnc.com/de/connect/download/viewer/ downloaden und installieren
b. Hostname eingeben und mit Pi verbinden

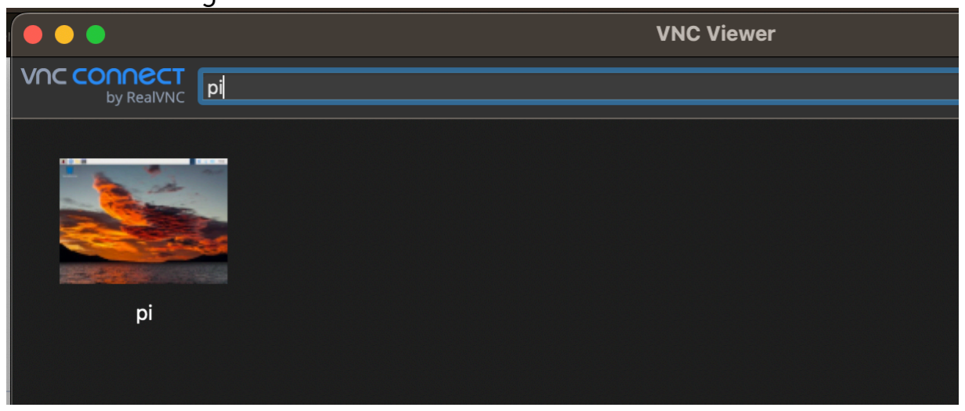
[picture p20: figure]

c. Jetzt kann der Raspberry Pi über VNC ferngesteuert werden.
4. Installiere Adafruit Blinka (https://learn.adafruit.com/circuitpython-on-raspberrypi-linux/installingcircuitpython-on-raspberry-pi) (https://learn.adafruit.com/circuitpython-on-raspberrypi-linux/installing-circuitpython-on-raspberry-pi)
5. Installiere die Module „adafruit_drv2605“ und „adafruit_tca9548a“
a. Im Terminal „sudo pip3 install adafruit-circuitpython-drv2605” eingeben
b. Im Terminal „sudo pip3 install adafruit-circuitpython-tca9548a” eingeben

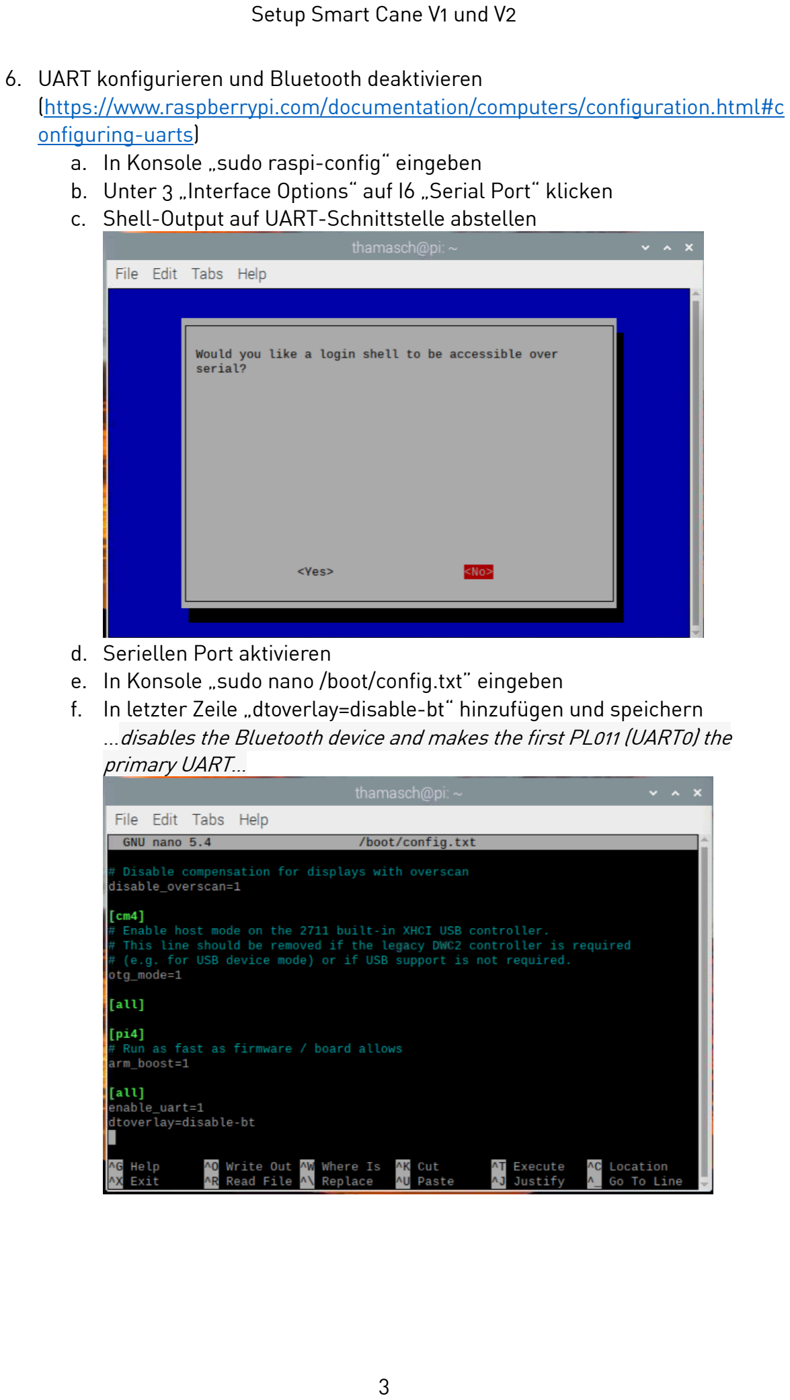
[picture p21: page 3]

6. UART konfigurieren und Bluetooth deaktivieren (https://www.raspberrypi.com/documentation/computers/configuration.html#c onfiguring-uarts) (https://www.raspberrypi.com/documentation/computers/configuration.html#configuring-uarts)
a. In Konsole „sudo raspi-config“ eingeben
b. Unter 3 „Interface Options“ auf I6 „Serial Port“ klicken
c. Shell-Output auf UART-Schnittstelle abstellen
d. Seriellen Port aktivieren
e. In Konsole „sudo nano /boot/config.txt” eingeben
f. In letzter Zeile „dtoverlay=disable-bt“ hinzufügen und speichern …disables the Bluetooth device and makes the first PL011 (UART0) the primary UART…

g. In Kosole „sudo systemctl disable hciuart” eingeben
h. Raspberry Pi Neustart
i. Kontrolle, ob Einstellung erfolgreich. In Konsole „ls -l /dev/serial*“ eingeben. Ausgabe müsste folgendermaßen aussehen:

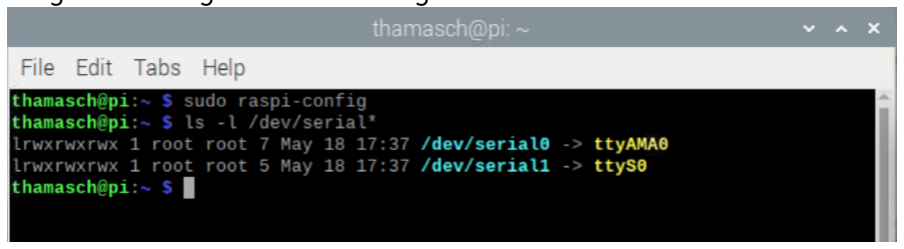
[picture p22: figure]

7. Autostart über rc.local konfigurieren (https://learn.sparkfun.com/tutorials/how-to-run-a-raspberry-pi-program-onstartup/all#method-1-rclocal) (https://learn.sparkfun.com/tutorials/how-to-run-a-raspberry-pi-program-on-startup/all)
a. In Konsole „sudo nano /etc/rc.local“ eingeben
b. In der Zeile vor „exit 0“ „python3“ + den absoluten Pfad des auszuführenden Programms eintragen (siehe auch Abbildung unten)

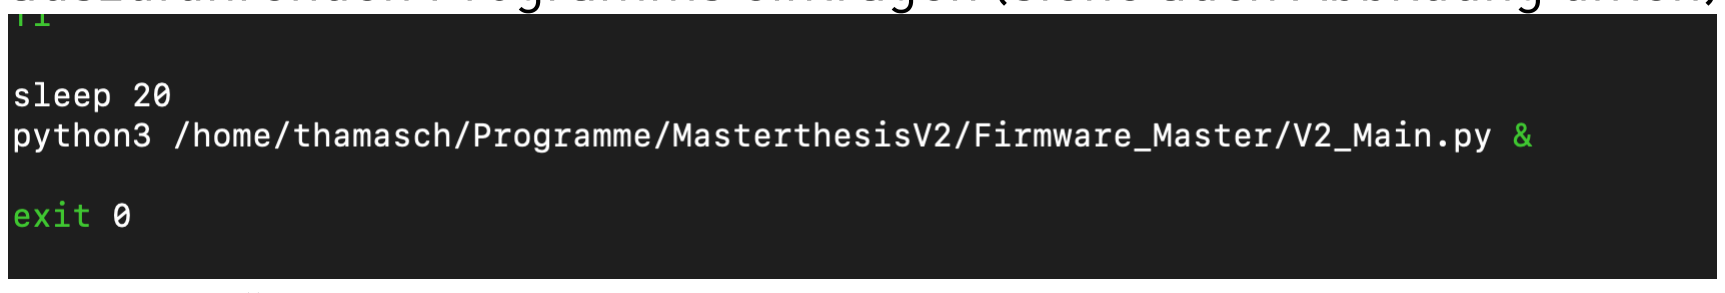
[picture p23: figure]

c. „sleep 20“ sorgt dafür, dass alle benötigten Dienste vor Programmstart ordnungsgemäß hochfahren können (ein sleep von 10 ist ausreichend)
d. „Note: the ampersand (&) at the end of the line is needed so that your Python script runs in a different process and does not block execution of the boot process. Without it, the rc.local script would wait for your script to end before continuing, and if you have an infinite loop […], you would never get a login prompt.”

Nützliche Shell-Befehle

python -V | zeigt installierte Python Version an
i2cdetect -y 1 | zeigt Teilnehmer des Busses mit Adresse an
