mw31ck3rt/h_da_SmartCane_2023/V.2/Hardware/Zeichnungen/rasterplatte.pdf

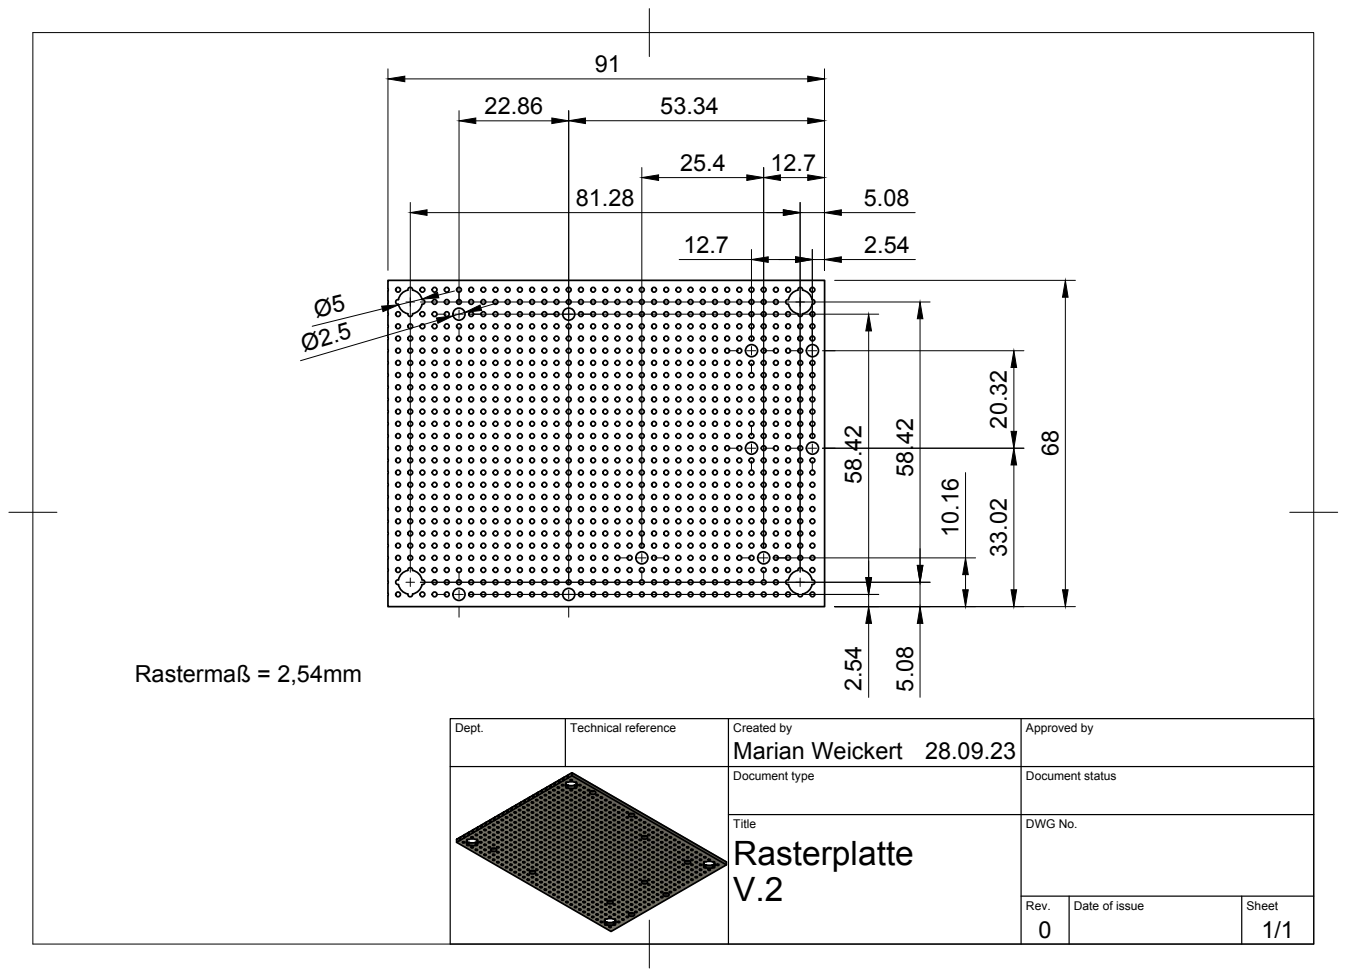
[picture p24: page 1]
Rastermaß = 2,54mm

Dept. | Technical reference | Created by Marian Weickert 28.09.23 | Approved by

Document type | Document status

Title Rasterplatte V.2 | DWG No.

Rev. 0 | Date of issue | Sheet 1/1
