mw31ck3rt/h_da_SmartCane_2023/V.2/Hardware/Zeichnungen/BP_rueck_vorne.pdf

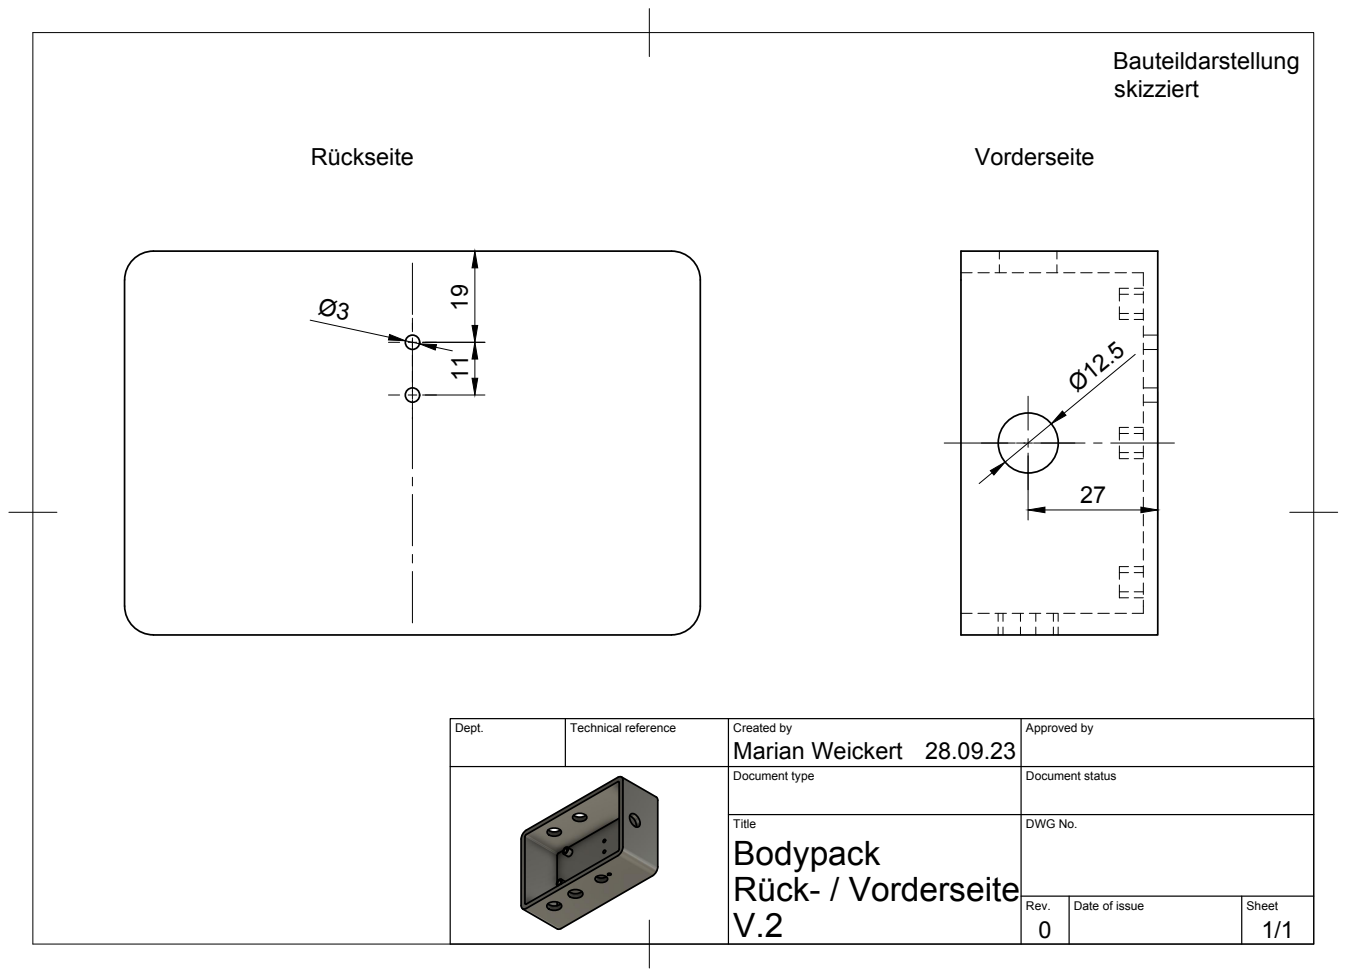
[picture p26: page 1]

Dept. | Technical reference | Created by Marian Weickert 28.09.23 | Approved by

Document type | Document status

Title Bodypack Rück- / Vorderseite V.2 | DWG No.

Rev. 0 | Date of issue | Sheet 1/1
