mw31ck3rt/h_da_SmartCane_2023/V.2/Hardware/Schaltpläne/Schaltplan_V2_technisch.pdf

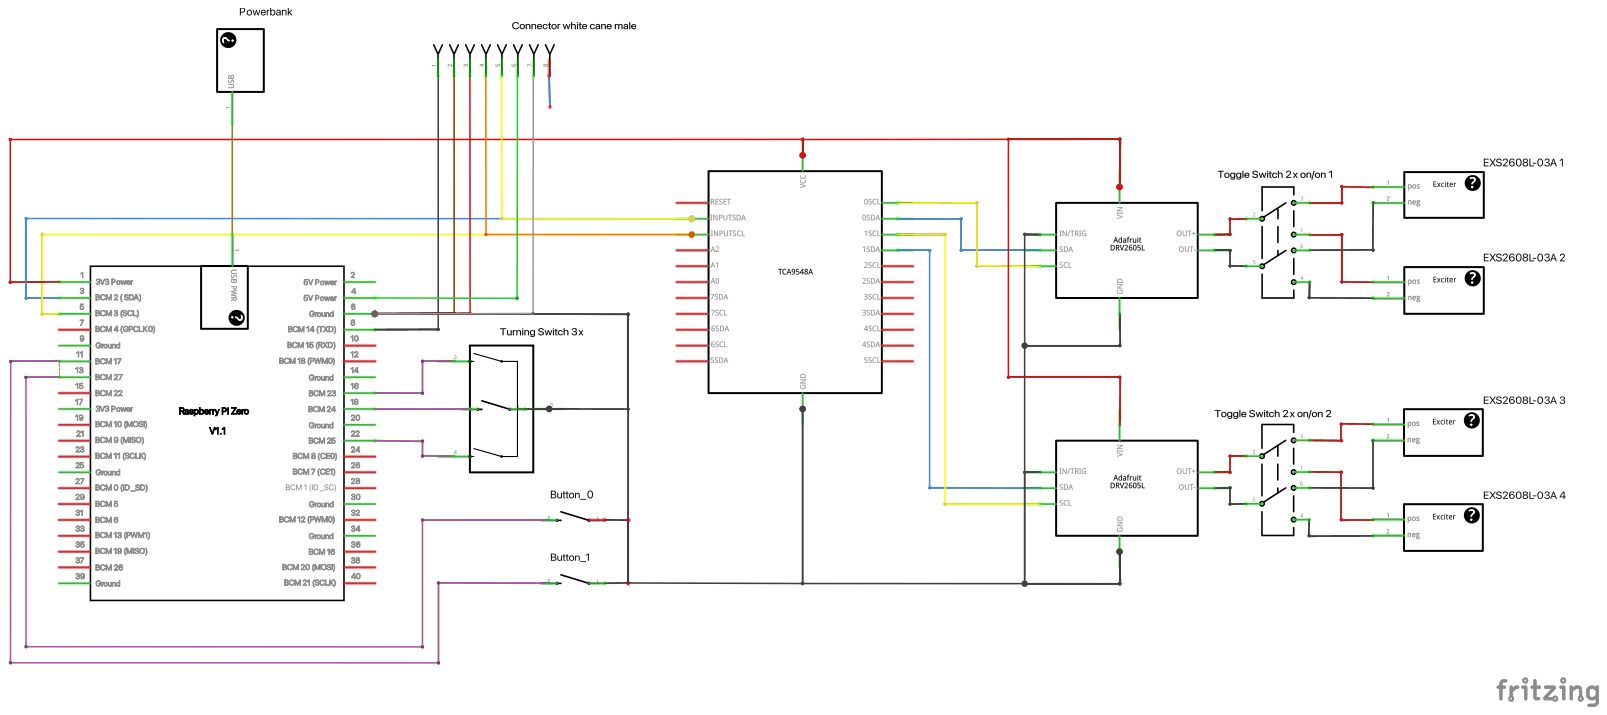
[picture p30: page 1]
