mw31ck3rt/h_da_SmartCane_2023/V.1/Hardware/Zeichnungen/bodypack_oben.pdf

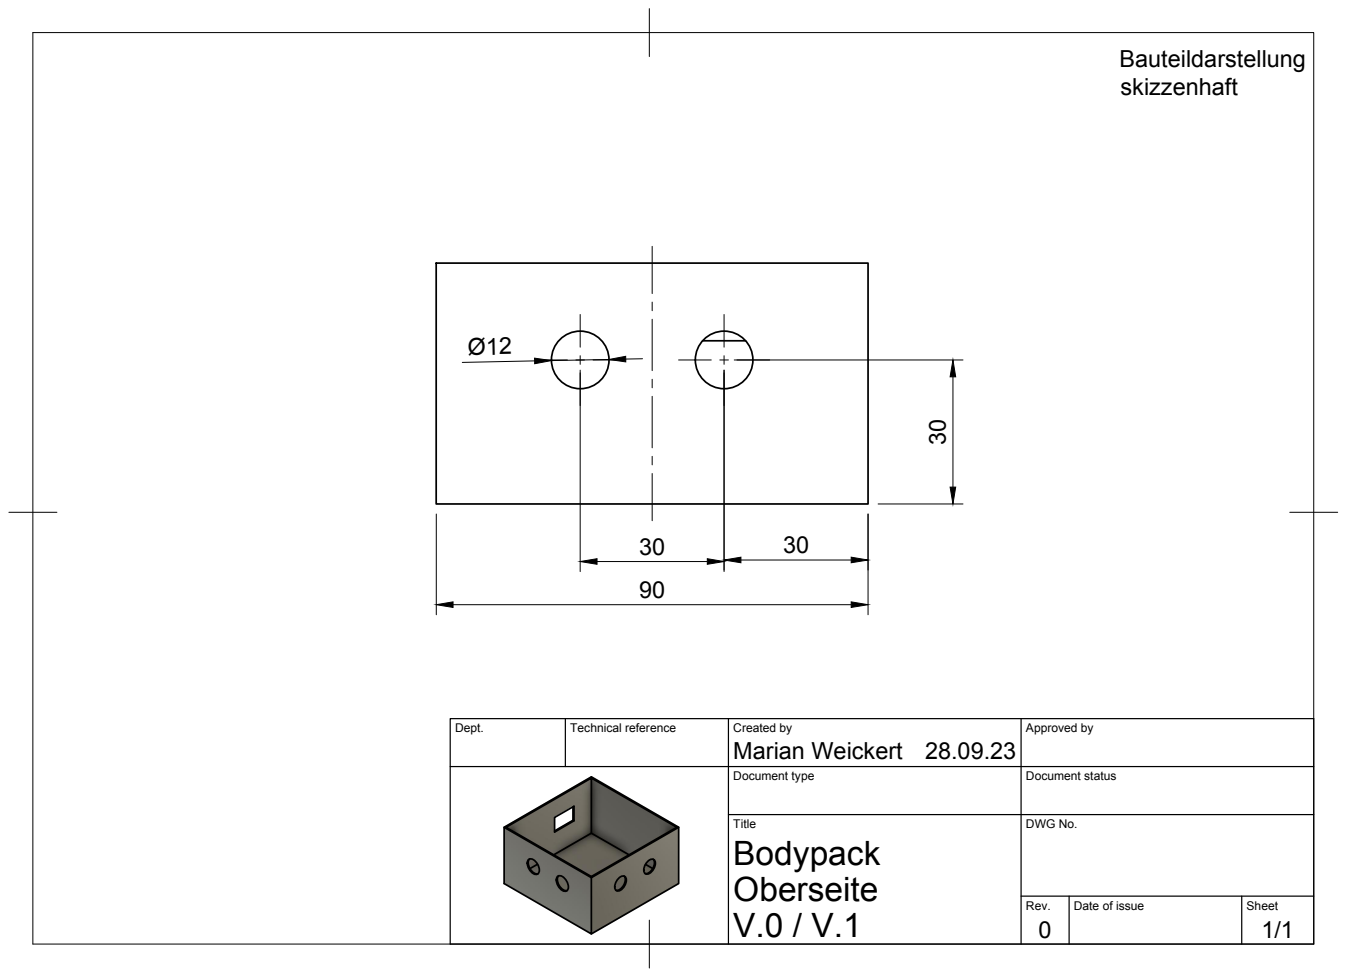
[picture p31: page 1]

Dept. | Technical reference | Created by Marian Weickert 28.09.23 | Approved by

Document type | Document status

Title Bodypack Oberseite V.0 / V.1 | DWG No.

Rev. 0 | Date of issue | Sheet

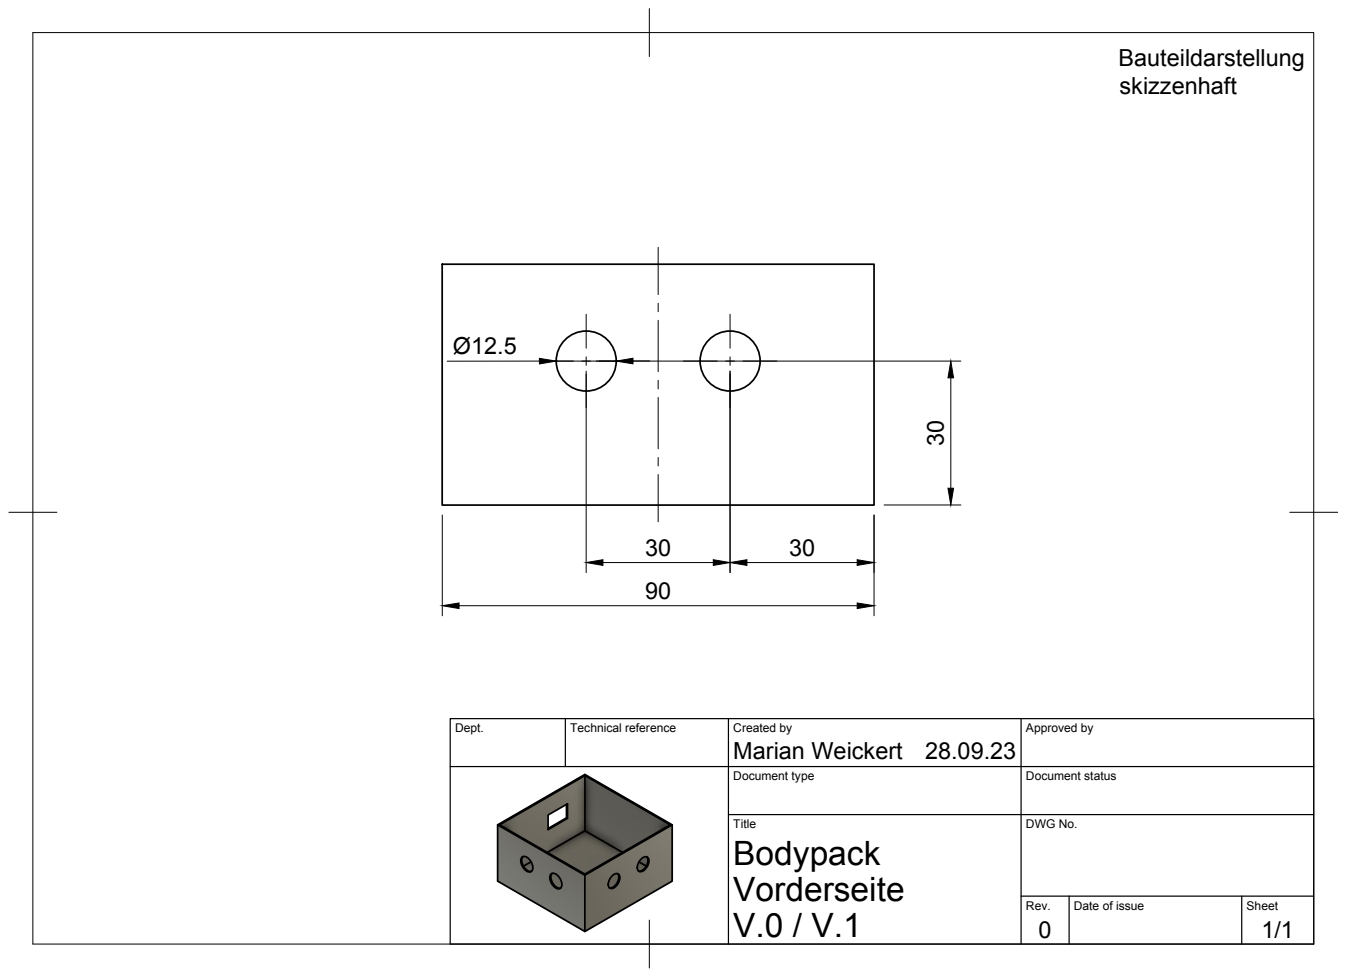
[picture p32: page 2]

Dept. | Technical reference | Created by Marian Weickert 28.09.23 | Approved by

Document type | Document status

Title Bodypack Vorderseite | DWG No.

Rev. | Date of issue | Sheet

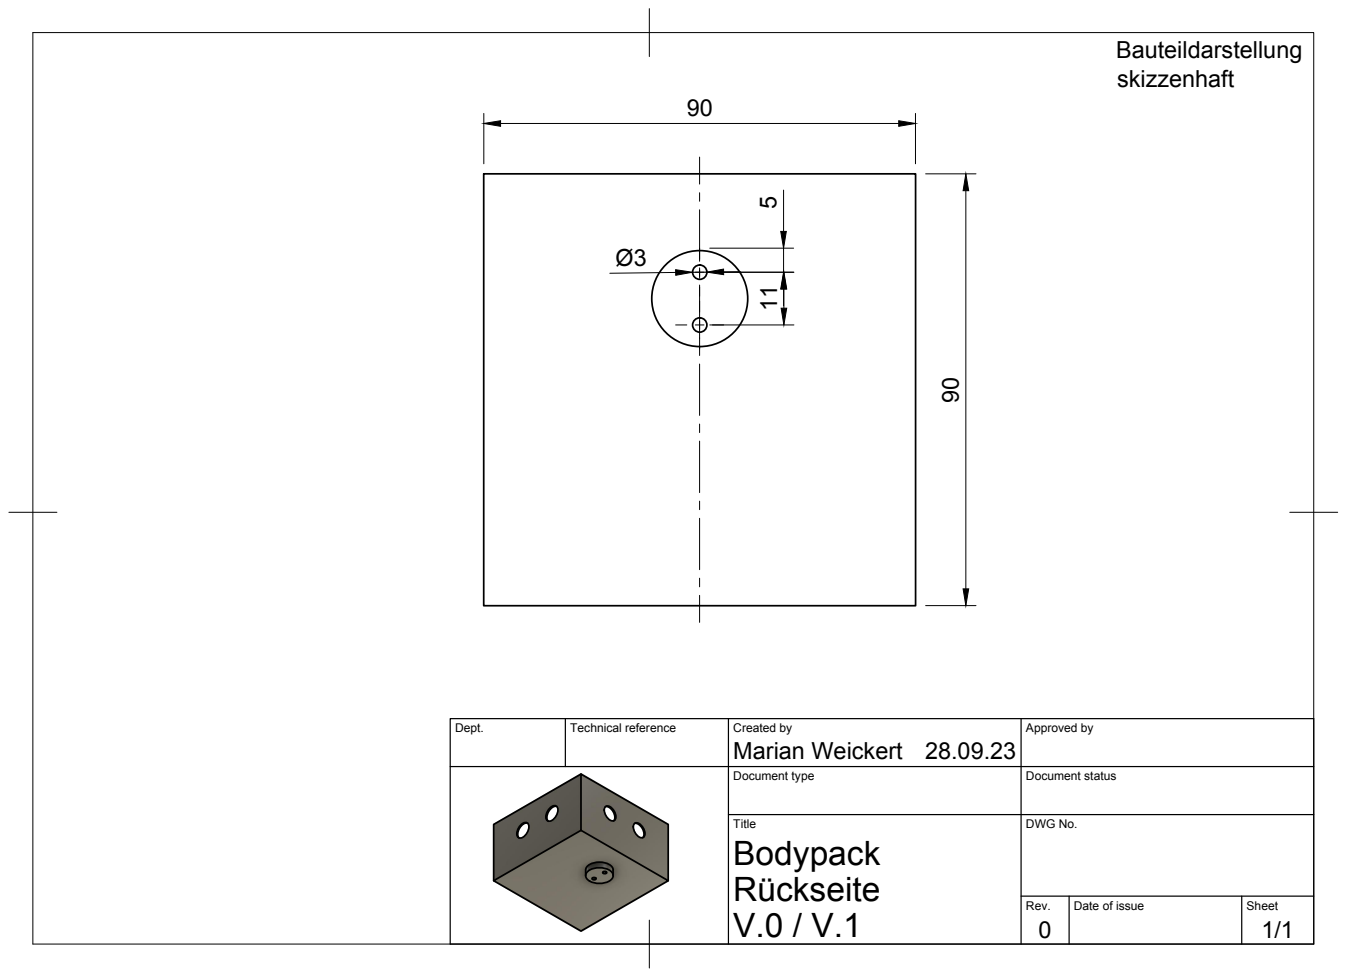
[picture p33: page 3]

Dept. | Technical reference | Created by Marian Weickert 28.09.23 | Approved by

Document type | Document status

Title Bodypack Rückseite | DWG No.

Rev. | Date of issue | Sheet

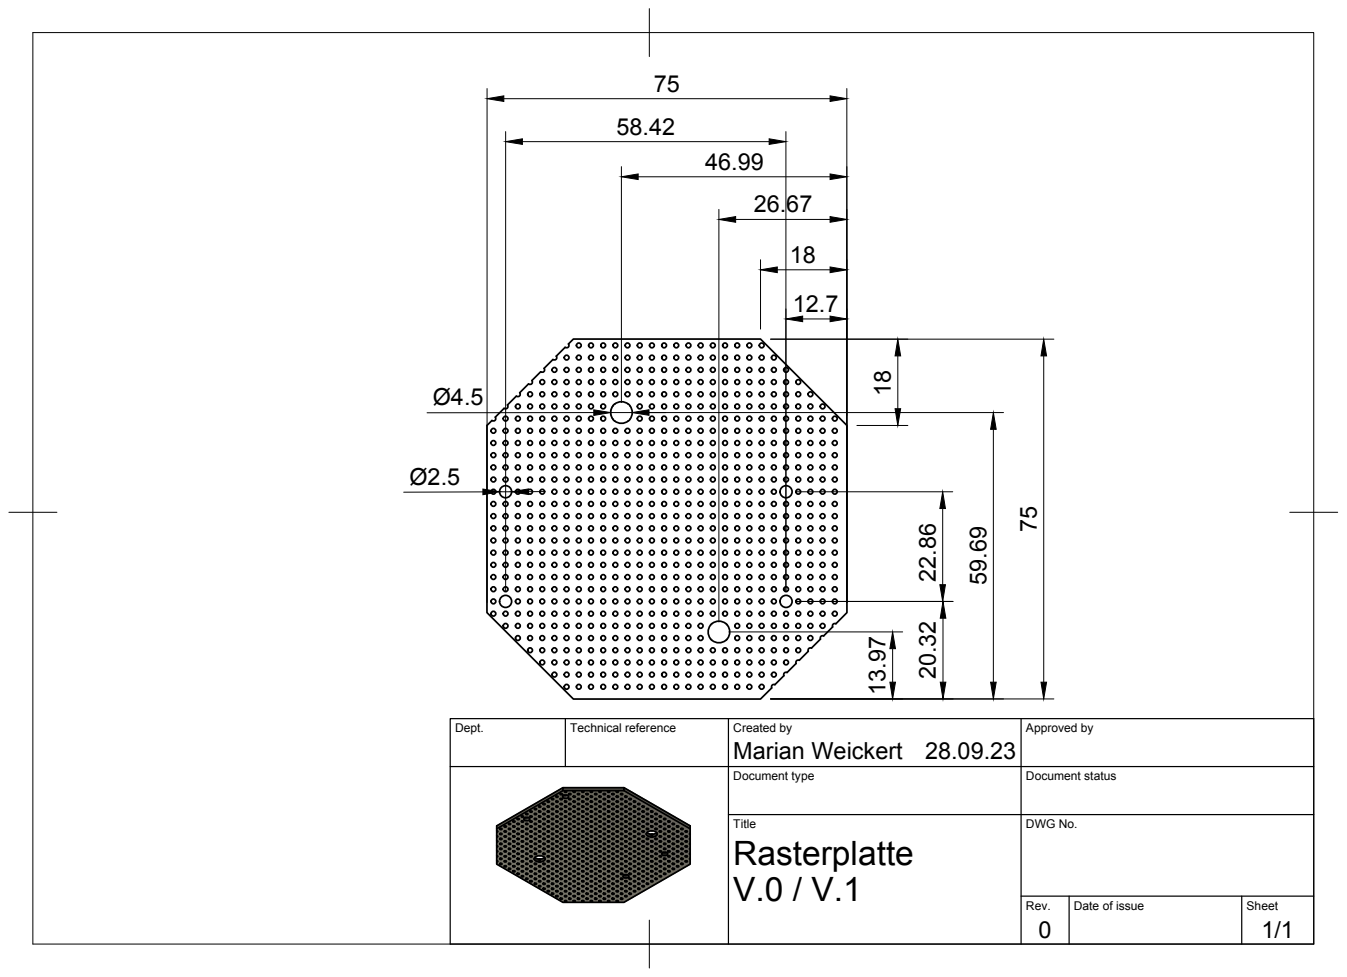
[picture p34: page 4]
Marian Weickert

Dept. | Technical reference | Created by 28.09.23 | Approved by

Document type | Document status

Title Rasterplatte V.0 / V.1 | DWG No.

Rev. 0 | Date of issue | Sheet

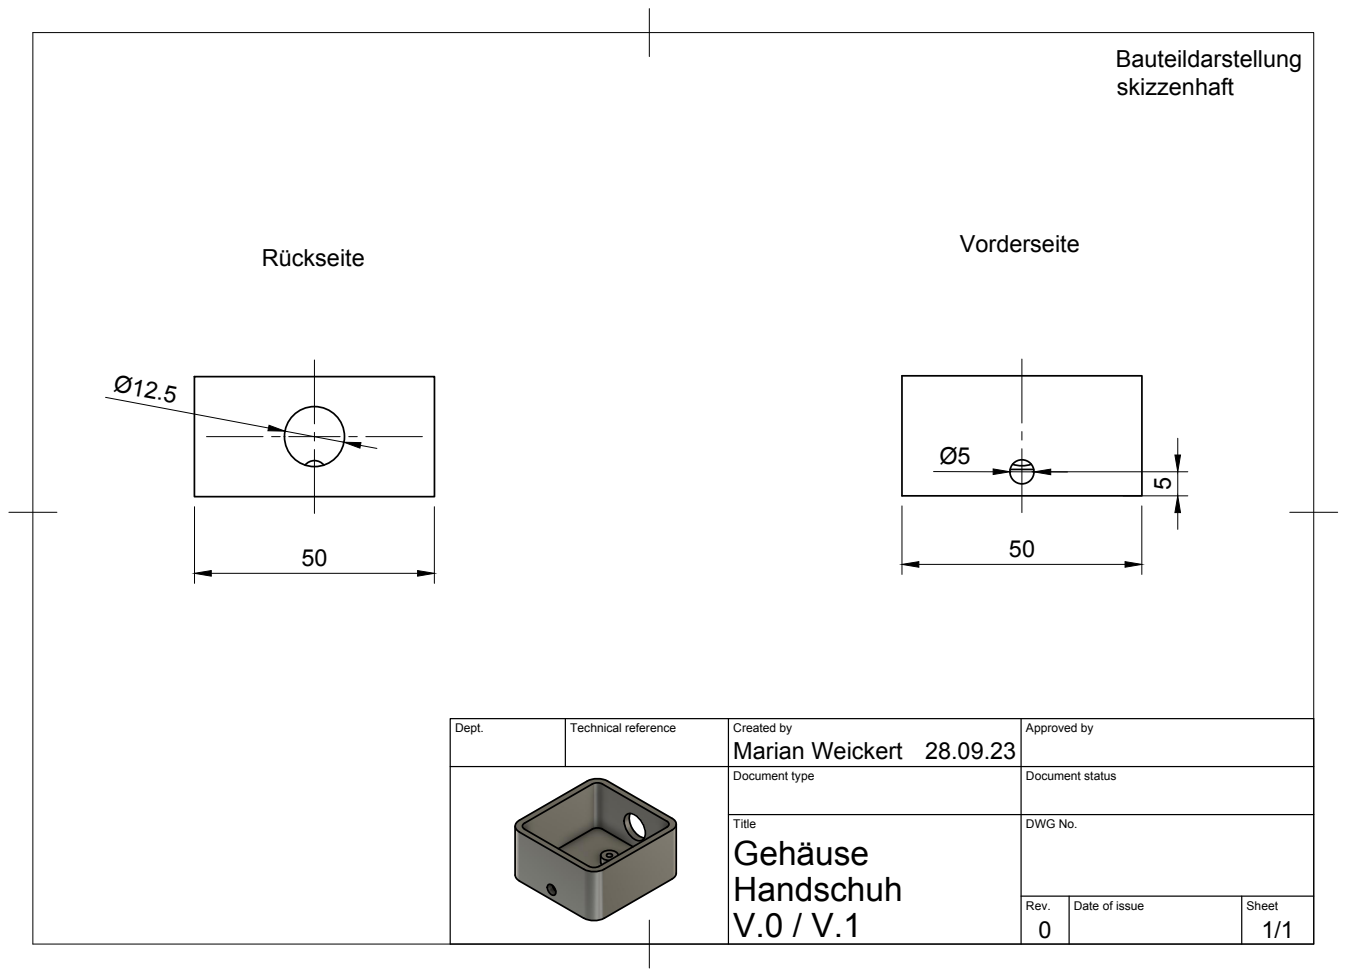
[picture p35: page 5]
Vorderseite Rückseite

Dept. | Technical reference | Created by Marian Weickert 28.09.23 | Approved by

Document type | Document status

Title Gehäuse Handschuh | DWG No.

Rev. | Date of issue | Sheet

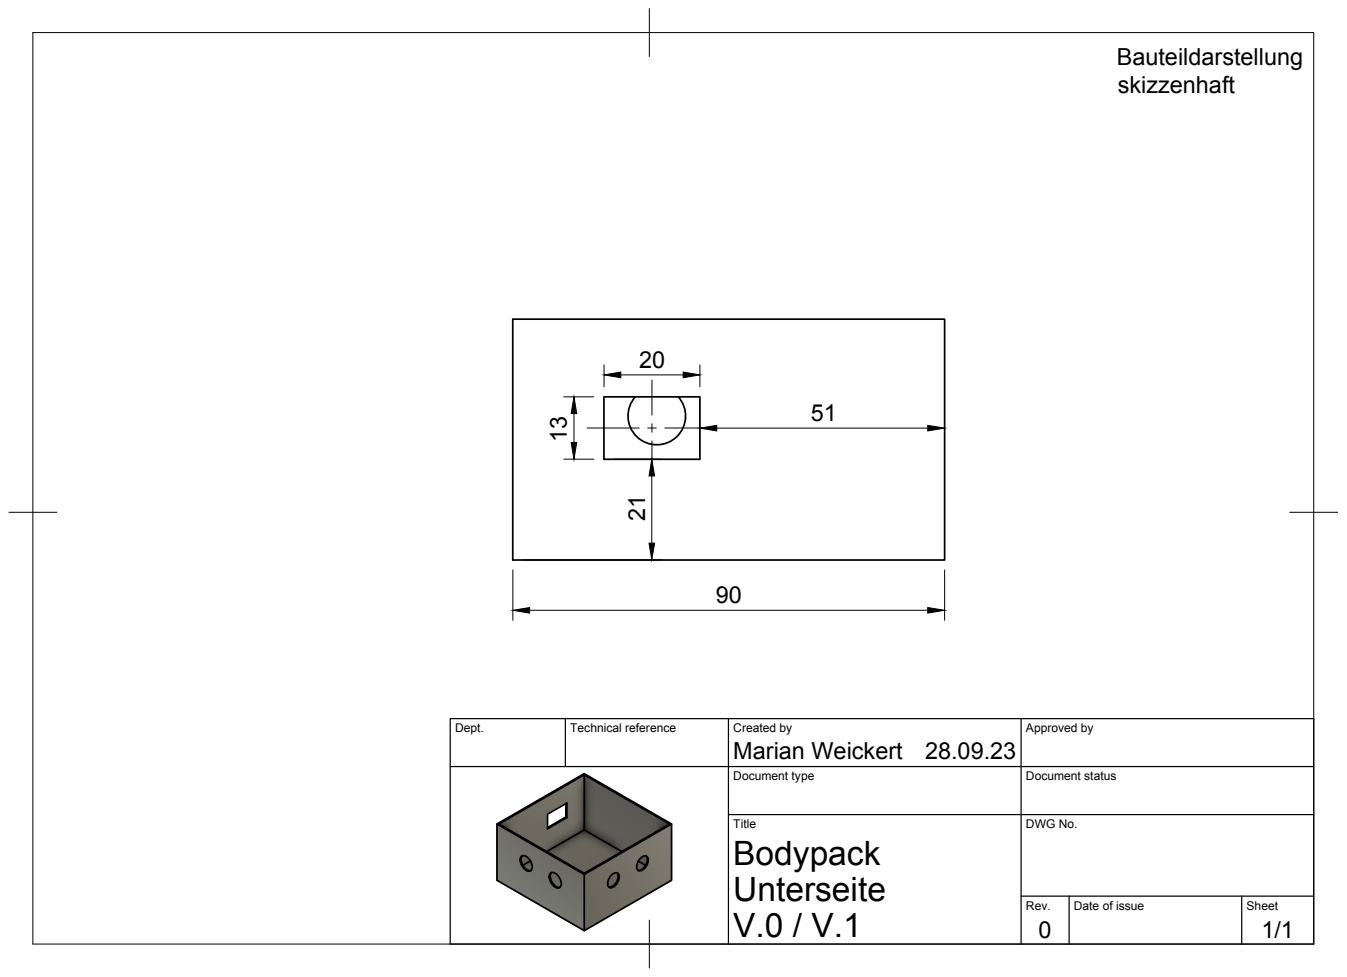
[picture p36: page 6]
Marian Weickert 13

Dept. | Technical reference | Created by 28.09.23 | Approved by

Document type | Document status

Title Bodypack Unterseite | DWG No.

Rev. | Date of issue | Sheet
