mw31ck3rt/h_da_SmartCane_2023/V.1/Hardware/Schaltpläne/Schaltplan_Bodypack.pdf

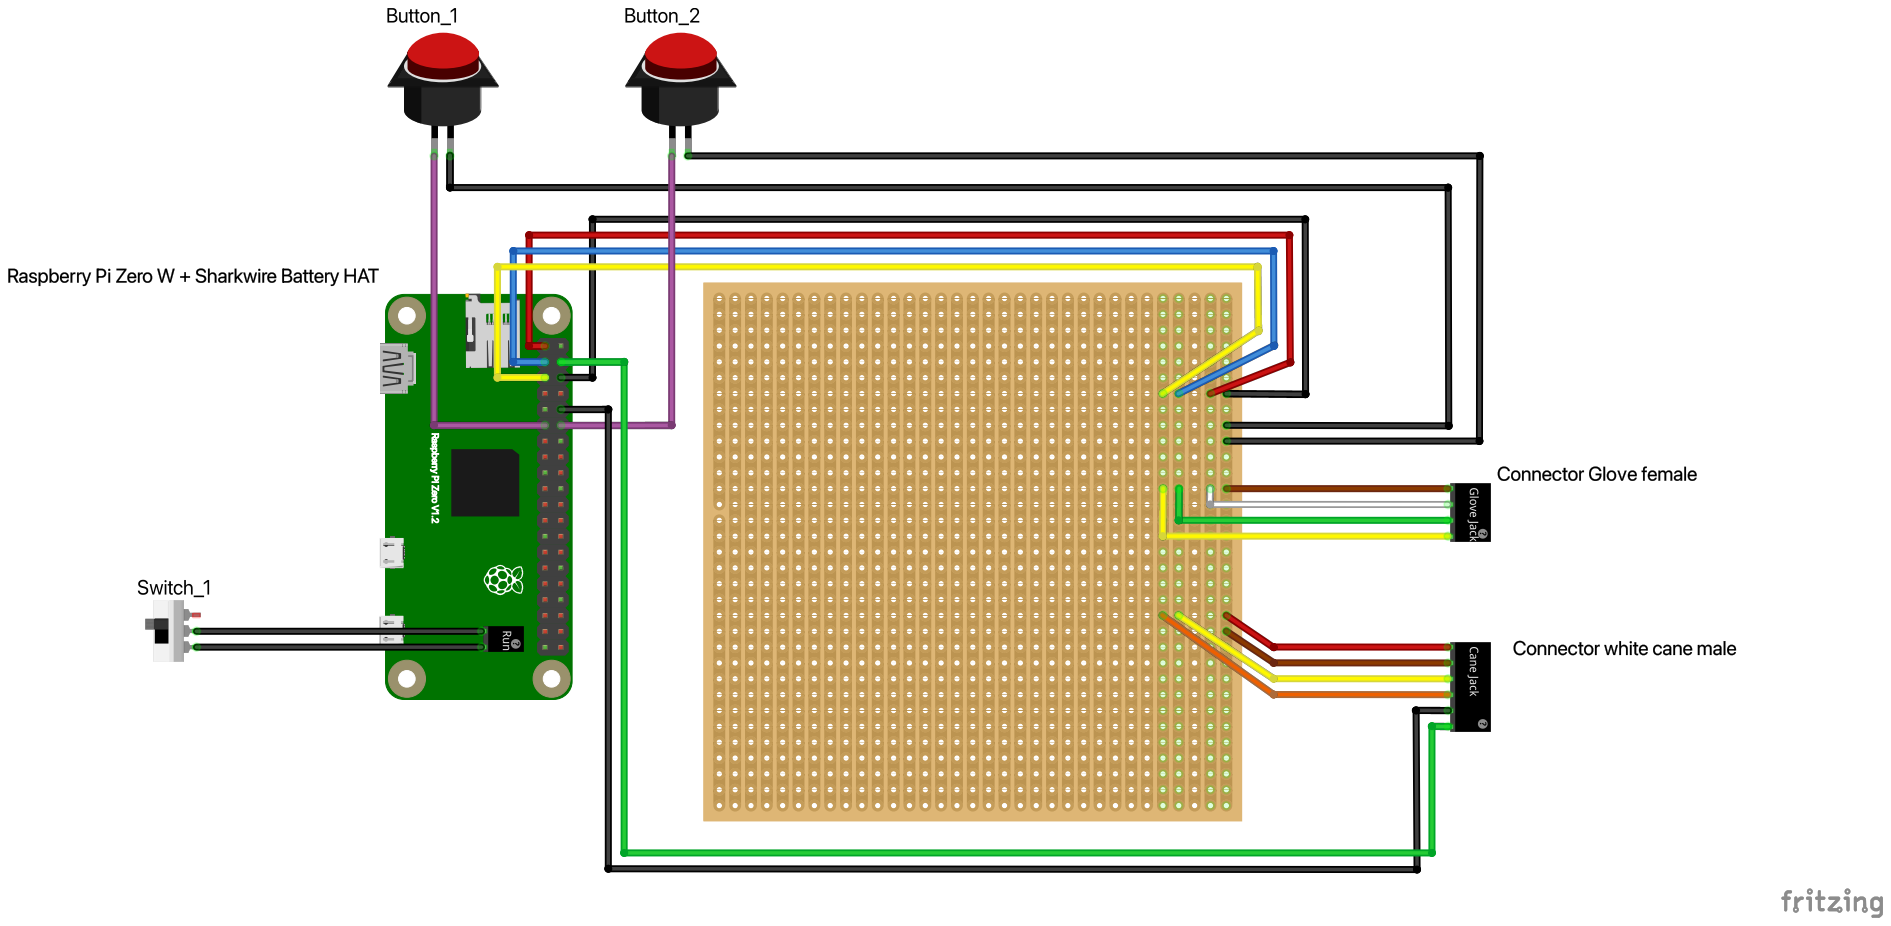
[picture p37: page 1]
