mw31ck3rt/h_da_SmartCane_2023/V.1/Hardware/Schaltpläne/Schaltplan_Handschuh.pdf

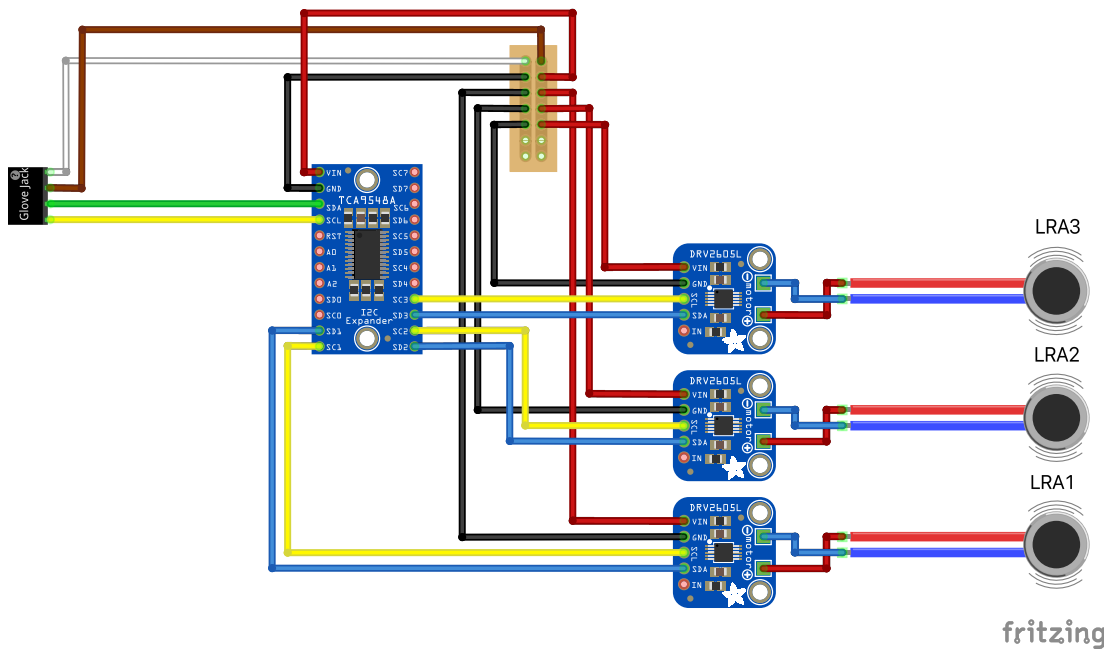
[picture p38: page 1]
